tivanis/FER_ESC/BOM/Basket_Nov01_0350PM.xls

SHOPPING BASKET
This is not an invoice
01-Nov-20 15:50:01
 | Mouser No | Mfr. No | Manufacturer | Customer No | Description | RoHS | Lifecycle | Order Qty. | Price (EUR) | Ext.: (EUR)
1 | 80-C0603C104Z3V | C0603C104Z3VACTU | KEMET | C6, C15, C20, C21, C2 | Multilayer Ceramic Capacitors MLCC - SMD/SMT 25V 0.1uF 0603 Y5V -20/+80% | RoHS Compliant |  | 30 | 0,012 € | 0,36 €
2 | 667-EEH-ZS1J151V | EEH-ZS1J151V | Panasonic | C7, C8, C9, C3, C4, C | Aluminium Organic Polymer Capacitors 63VDC 150uF Anti-V Hybrid Cap AEC-Q200 | RoHS Compliant |  | 8 | 2,29 € | 18,32 €
3 | 80-C0603C102K1R | C0603C102K1RACTU | KEMET | C10, C19, C22, | Multilayer Ceramic Capacitors MLCC - SMD/SMT 100V 1000pF 0603 X7R 10% | RoHS Compliant |  | 3 | 0,085 € | 0,26 €
4 | 187-CL32B106KMVNNWE | CL32B106KMVNNWE | Samsung Electro-Mechanics | C11, C12, C13, C14, | Multilayer Ceramic Capacitors MLCC - SMD/SMT | RoHS Compliant | New At Mouser | 4 | 0,72 € | 2,88 €
5 | 80-C1206C224MMRECTU | C1206C224MMRECTU | KEMET | C16, C17, C18, | Multilayer Ceramic Capacitors MLCC - SMD/SMT 63V 0.22uF X7R 1206 20% | RoHS Compliant |  | 3 | 0,271 € | 0,81 €
6 | 81-GRM21BC72A105KE1L | GRM21BC72A105KE01L | Murata | C23, C24, | Multilayer Ceramic Capacitors MLCC - SMD/SMT 1.0UF 100V 10% 0805 | RoHS Compliant |  | 2 | 0,356 € | 0,71 €
7 | 710-885012107018 | 885012107018 | Wurth Elektronik | C26, C27, C46, C55, C | Multilayer Ceramic Capacitors MLCC - SMD/SMT WCAP-CSGP 4.7uF 0805 20% 25V MLCC | RoHS Compliant |  | 5 | 0,144 € | 0,72 €
8 | 77-VJ805Y105KXXTW1BC | VJ0805Y105KXXTW1BC | Vishay | C28, | Multilayer Ceramic Capacitors MLCC - SMD/SMT 1uF 25volts 10% | RoHS Compliant |  | 1 | 0,144 € | 0,14 €
9 | 963-EMK212BBJ106MGHT | EMK212BBJ106MGHT | Taiyo Yuden | C29, C33, C30, C34, C | Multilayer Ceramic Capacitors MLCC - SMD/SMT 0805 16VDC 10uF 20% X5R AEC-Q200 | RoHS Compliant |  | 8 | 0,203 € | 1,62 €
10 | 710-885012206077 | 885012206077 | Wurth Elektronik | C37, C38, C39, | Multilayer Ceramic Capacitors MLCC - SMD/SMT WCAP-CSGP 100pF 0603 10% 50V MLCC | RoHS Compliant |  | 3 | 0,085 € | 0,26 €
11 | 80-C0603C104M5R | C0603C104M5RACTU | KEMET | C40, | Multilayer Ceramic Capacitors MLCC - SMD/SMT 50V 0.1uF 0603 X7R 20% | RoHS Compliant |  | 1 | 0,085 € | 0,09 €
12 | 710-885012206089 | 885012206089 | Wurth Elektronik | C41, | Multilayer Ceramic Capacitors MLCC - SMD/SMT WCAP-CSGP 0.01uF 0603 10% 50V MLCC | RoHS Compliant |  | 1 | 0,085 € | 0,09 €
13 | 77-VJ0603A470JXXPBC | VJ0603A470JXXPW1BC | Vishay | C45, C47, | Multilayer Ceramic Capacitors MLCC - SMD/SMT 0603 47pF 25volts C0G 5% | RoHS Compliant |  | 2 | 0,085 € | 0,17 €
14 | 710-885012207128 | 885012207128 | Wurth Elektronik | C53, C60, C51, | Multilayer Ceramic Capacitors MLCC - SMD/SMT WCAP-CSGP 100V 0.1uF 0805 10% | RoHS Compliant |  | 3 | 0,085 € | 0,26 €
15 | 80-C0603C223K1R | C0603C223K1RACTU | KEMET | C59, | Multilayer Ceramic Capacitors MLCC - SMD/SMT 100V .022uF 0603 X7R 10% | RoHS Compliant |  | 1 | 0,085 € | 0,09 €
16 | 603-CC0603JRX77BB474 | CC0603JRX7R7BB474 | Yageo | C61, C62, C63, | Multilayer Ceramic Capacitors MLCC - SMD/SMT 16V 0.47uF X7R 0603 0.05 | RoHS Compliant |  | 3 | 0,186 € | 0,56 €
17 | 187-CL10A225KO8NNNC | CL10A225KO8NNNC | Samsung Electro-Mechanics | C78, C75, C72, C69, C | Multilayer Ceramic Capacitors MLCC - SMD/SMT | RoHS Compliant | New At Mouser | 6 | 0,093 € | 0,56 €
18 | 603-AC0402JRNP9BN300 | AC0402JRNPO9BN300 | Yageo | C84, C83, | Multilayer Ceramic Capacitors MLCC - SMD/SMT 30pF 5% 50V AEC-Q200 | RoHS Compliant By Exemption |  | 2 | 0,085 € | 0,17 €
19 | 833-BAT54S-TP | BAT54S-TP | Micro Commercial Components (MCC) | D1, D2, D3, D4, | Schottky Diodes & Rectifiers 30V 200mA 0.6A 200mW 2.0uA 10pF | RoHS Compliant |  | 4 | 0,229 € | 0,92 €
20 | 755-RB168MM100TFTR | RB168MM100TFTR | ROHM Semiconductor | D5, | Schottky Diodes & Rectifiers 100V VR 1A 0.81V VF PMDU; SOD-123FL | RoHS Compliant | New Product | 1 | 0,339 € | 0,34 €
21 | 710-155060VS75300 | 155060VS75300 | Wurth Elektronik | D6, D7, D8, D10, | Standard LEDs - SMD WL-SMSW Wtrclr SdVw Grn 2V 20mA 572nm | RoHS Compliant | New Product | 4 | 0,322 € | 1,29 €
22 | 710-150060RS75000 | 150060RS75000 | Wurth Elektronik | D9, | Standard LEDs - SMD WL-SMCW SMDMono TpVw Waterclr 0603 Red | RoHS Compliant |  | 1 | 0,127 € | 0,13 €
23 | 581-F0603G0R15FNTR | F0603G0R15FNTR | AVX | F1, | Surface Mount Fuses 150 mA fuse | In Transition |  | 1 | 0,686 € | 0,69 €
24 | 963-BKP2125HS600-T | BKP2125HS600-T | Taiyo Yuden | FB1, | Ferrite Beads HI CUR LW RDC 0805 60OHMS 25% | RoHS Compliant |  | 1 | 0,085 € | 0,09 €
25 | 538-105314-1206 | 105314-1206 | Molex | J1, J4, | Headers & Wire Housings NanoFit RA Hdr TH DR 6Ckt 0.38um Au Blk | RoHS Compliant |  | 2 | 1,58 € | 3,16 €
26 | 649-10103594-0001LF | 10103594-0001LF | FCI / Amphenol | J3, | USB Connectors 5P Quick Connect Micro USB TypeB Rcpt | RoHS Compliant |  | 1 | 0,644 € | 0,64 €
27 | 538-22-28-4041 | 22-28-4041 | Molex | J5, | Headers & Wire Housings BKWY HDR STR 4P tin | RoHS Compliant |  | 1 | 0,178 € | 0,18 €
28 | 538-87914-1026 | 87914-1026 | Molex | J6, | Headers & Wire Housings 2.54mm DRSW Hdr TH 10Ckt | RoHS Compliant |  | 1 | 0,661 € | 0,66 €
29 | 875-TYS40306R8M-10 | TYS40306R8M-10 | Laird Performance Materials | L1, | Fixed Inductors 6.8uH 20% -40C +125C | RoHS Compliant |  | 1 | 0,229 € | 0,23 €
30 | 652-MH1608-300Y | MH1608-300Y | Bourns | L2, | Ferrite Beads 30 ohms 25% HIGH CURRENT | RoHS Compliant |  | 1 | 0,085 € | 0,09 €
31 | 863-NVBLS001N06C | NVBLS001N06C | ON Semiconductor | Q3, Q5, Q6, Q4, Q1, Q | MOSFET NFET TOLL 60V 1.0MO | RoHS Compliant | New Product | 6 | 3,67 € | 22,02 €
32 | 667-ERJ-P06J6R2V | ERJ-P06J6R2V | Panasonic | R1, R2, R10, R11, R22 | Thick Film Resistors - SMD 0805 6.2ohms 0.5W 5% Tol AEC-Q200 | RoHS Compliant By Exemption |  | 6 | 0,246 € | 1,48 €
33 | 652-CR0603FX-39R0ELF | CR0603-FX-39R0ELF | Bourns | R5, R12, R19, R26, R6 | Thick Film Resistors - SMD 39 ohm 1% | RoHS Compliant By Exemption |  | 8 | 0,085 € | 0,68 €
34 | 652-CR0603FX-4422ELF | CR0603-FX-4422ELF | Bourns | R8, R15, R20, R27, | Thick Film Resistors - SMD 44.2K ohm 1% | RoHS Compliant By Exemption |  | 4 | 0,085 € | 0,34 €
35 | 652-CR0603FX-2401ELF | CR0603-FX-2401ELF | Bourns | R9, R16, R21, R28, | Thick Film Resistors - SMD 2.4K ohm 1% | RoHS Compliant By Exemption |  | 4 | 0,085 € | 0,34 €
36 | 667-ERJ-PA3J223V | ERJ-PA3J223V | Panasonic | R25, R24, R14, R13, R | Thick Film Resistors - SMD 0603 22Kohm 5% Anti-Surge AEC-Q200 |  |  | 6 | 0,093 € | 0,56 €
37 | 652-CSS2H2512K3L00FE | CSS2H-2512K-3L00FE | Bourns | R30, R29, R18, R17, R | Current Sense Resistors - SMD 3.0mOHMS 4W 1% AEC-Q200 | RoHS Compliant |  | 6 | 0,737 € | 4,42 €
38 | 652-CR0603-FX-103ELF | CR0603-FX-1003ELF | Bourns | R31, | Thick Film Resistors - SMD 100K 1% 1/10 WATT | RoHS Compliant By Exemption |  | 1 | 0,085 € | 0,09 €
39 | 660-RN731JTTD5562B25 | RN731JTTD5562B25 | KOA Speer | R32, | Thin Film Resistors - SMD 0603 55K6 Ohms 0.1% 25PPM | RoHS Compliant |  | 1 | 0,674 € | 0,67 €
40 | 667-ERA-3AEB103V | ERA-3AEB103V | Panasonic | R33, R72, R73, | Thin Film Resistors - SMD 0603 1/10W 10Kohms 0.1% 25ppm | RoHS Compliant By Exemption |  | 3 | 0,296 € | 0,89 €
41 | 652-CR0603FX-3300ELF | CR0603-FX-3300ELF | Bourns | R34, R59, R60, R71, | Thick Film Resistors - SMD 330 ohm 1% | RoHS Compliant By Exemption |  | 4 | 0,085 € | 0,34 €
42 | 652-CR0603-FX-2001LF | CR0603-FX-2001ELF | Bourns | R37, R36, R35, R76, R | Thick Film Resistors - SMD 2K OHM 1% | RoHS Compliant By Exemption |  | 5 | 0,076 € | 0,38 €
43 | 652-CR0603FX-4701ELF | CR0603-FX-4701ELF | Bourns | R38, R40, R39, | Thick Film Resistors - SMD 4.7K ohm 1% | RoHS Compliant By Exemption |  | 3 | 0,085 € | 0,26 €
44 | 652-CR0603FX-1302ELF | CR0603-FX-1302ELF | Bourns | R41, R45, R49, | Thick Film Resistors - SMD 13K 1% 1/10W | RoHS Compliant By Exemption |  | 3 | 0,085 € | 0,26 €
45 | 652-CR0603FX-1332ELF | CR0603-FX-1332ELF | Bourns | R42, R46, R50, | Thick Film Resistors - SMD 13.3K 1% 1/10W | RoHS Compliant By Exemption |  | 3 | 0,085 € | 0,26 €
46 | 652-CR0603FX-2003ELF | CR0603-FX-2003ELF | Bourns | R43, R47, R51, | Thick Film Resistors - SMD 200K ohm 1% | RoHS Compliant By Exemption |  | 3 | 0,085 € | 0,26 €
47 | 652-CR0603-FX3301ELF | CR0603-FX-3301ELF | Bourns | R44, R48, R52, R53, R | Thick Film Resistors - SMD 3.3KOHM 1/10WATT 1% | RoHS Compliant |  | 11 | 0,023 € | 0,25 €
48 | 667-ERJ-3EKF60R4V | ERJ-3EKF60R4V | Panasonic | R54, R55, | Thick Film Resistors - SMD 0603 60.4ohms 1% AEC-Q200 | RoHS Compliant By Exemption |  | 2 | 0,085 € | 0,17 €
49 | 652-CR0603FX-27R0ELF | CR0603-FX-27R0ELF | Bourns | R56, R57, | Thick Film Resistors - SMD 27 ohm 1% | RoHS Compliant By Exemption |  | 2 | 0,085 € | 0,17 €
50 | 652-CR0603FX-1002ELF | CR0603-FX-1002ELF | Bourns | R58, R61, R65, | Thick Film Resistors - SMD 10K 1% 1/10W | RoHS Compliant By Exemption |  | 3 | 0,085 € | 0,26 €
51 | 603-AC0603JR-100RL | AC0603JR-100RL | Yageo | R66, R67, R74, | Thick Film Resistors - SMD 0 ohm 5% 75V AEC-Q200 | RoHS Compliant By Exemption |  | 3 | 0,085 € | 0,26 €
52 | 652-CR0603AFX10R0EAS | CR0603AFX-10R0EAS | Bourns | R70, R69, R68, | Thick Film Resistors - SMD ResA-AS 0603 10R 1% 100mW TC100 | RoHS Compliant | New Product | 3 | 0,085 € | 0,26 €
53 | 688-SKRKAEE020 | SKRKAEE020 | Alps Alpine | SW1, | Tactile Switches 3.9x2.9x2.0mm 160gf Packaging Temp 80oC | RoHS Compliant |  | 1 | 0,626 € | 0,63 €
54 | 595-LMR16006XDDCR | LMR16006XDDCR | Texas Instruments | U1, | Switching Voltage Regulators LMR16006 SIMPLE SWIT 60V Buck | RoHS Compliant |  | 1 | 2,38 € | 2,38 €
55 | 511-LD1117S33 | LD1117S33TR | STMicroelectronics | U2, | LDO Voltage Regulators 3.3V 0.8A Positive | RoHS Compliant |  | 1 | 0,347 € | 0,35 €
56 | 511-LD1117S12 | LD1117S12TR | STMicroelectronics | U3, | LDO Voltage Regulators 1.2V 0.8A Positive | RoHS Compliant |  | 1 | 0,407 € | 0,41 €
57 | 595-TLC374CDR | TLC374CDR | Texas Instruments | U4, | Analog Comparators Quad Differential | RoHS Compliant |  | 1 | 1,14 € | 1,14 €
58 | 595-TCAN1042VDRQ1 | TCAN1042VDRQ1 | Texas Instruments | U5, | CAN Interface IC | RoHS Compliant |  | 1 | 1,11 € | 1,11 €
59 | 595-TPD2EUSB30ADRTR | TPD2EUSB30ADRTR | Texas Instruments | U6, | ESD Suppressors / TVS Diodes 2 Channel ESD/ Surge Solution | RoHS Compliant |  | 1 | 0,474 € | 0,47 €
60 | 895-FT230XS-R | FT230XS-R | FTDI | U7, | USB Interface IC USB to Basic Serial UART IC SSOP-16 | RoHS Compliant |  | 1 | 1,73 € | 1,73 €
61 | 771-NXS0104PW-Q100J | NXS0104PW-Q100J | Nexperia | U8, | Translation - Voltage Levels 3 STATE DUAL SUPPLY TRANS | RoHS Compliant | New Product | 1 | 0,584 € | 0,58 €
62 | 815-ABLS7M-20-B-2-T | ABLS7M-20.000MHZ-B-2-T | ABRACON | Y1, | Crystals 20.0MHz 18pF 50ppm -20C +70C | RoHS Compliant |  | 1 | 0,288 € | 0,29 €
63 | 595-F280049PZS | F280049PZS | Texas Instruments |  | 32-bit Microcontrollers - MCU | RoHS Compliant |  | 1 | 7,26 € | 7,26 €
64 | 538-105313-1203 | 105313-1203 | Molex |  | Headers & Wire Housings NanoFit RA Hdr TH SR 3Ckt 0.38UM Au Blk | RoHS Compliant |  | 2 | 1,06 € | 2,12 €
By submitting your order you agree to these terms and conditions. (https://hr.mouser.com/saleterms) |  |  |  |  |  |  |  |  | Merchandise Total: | 89,58 €
Prices are reflected at the date and time shown. |  |  |  |  |  |  |  |  | Delivery Charge: | 0,00 €
 |  |  |  |  |  |  |  |  | Back-order Delivery: | Estimate
