tivanis/FER_ESC/FER_ESC_v2r1.pdf

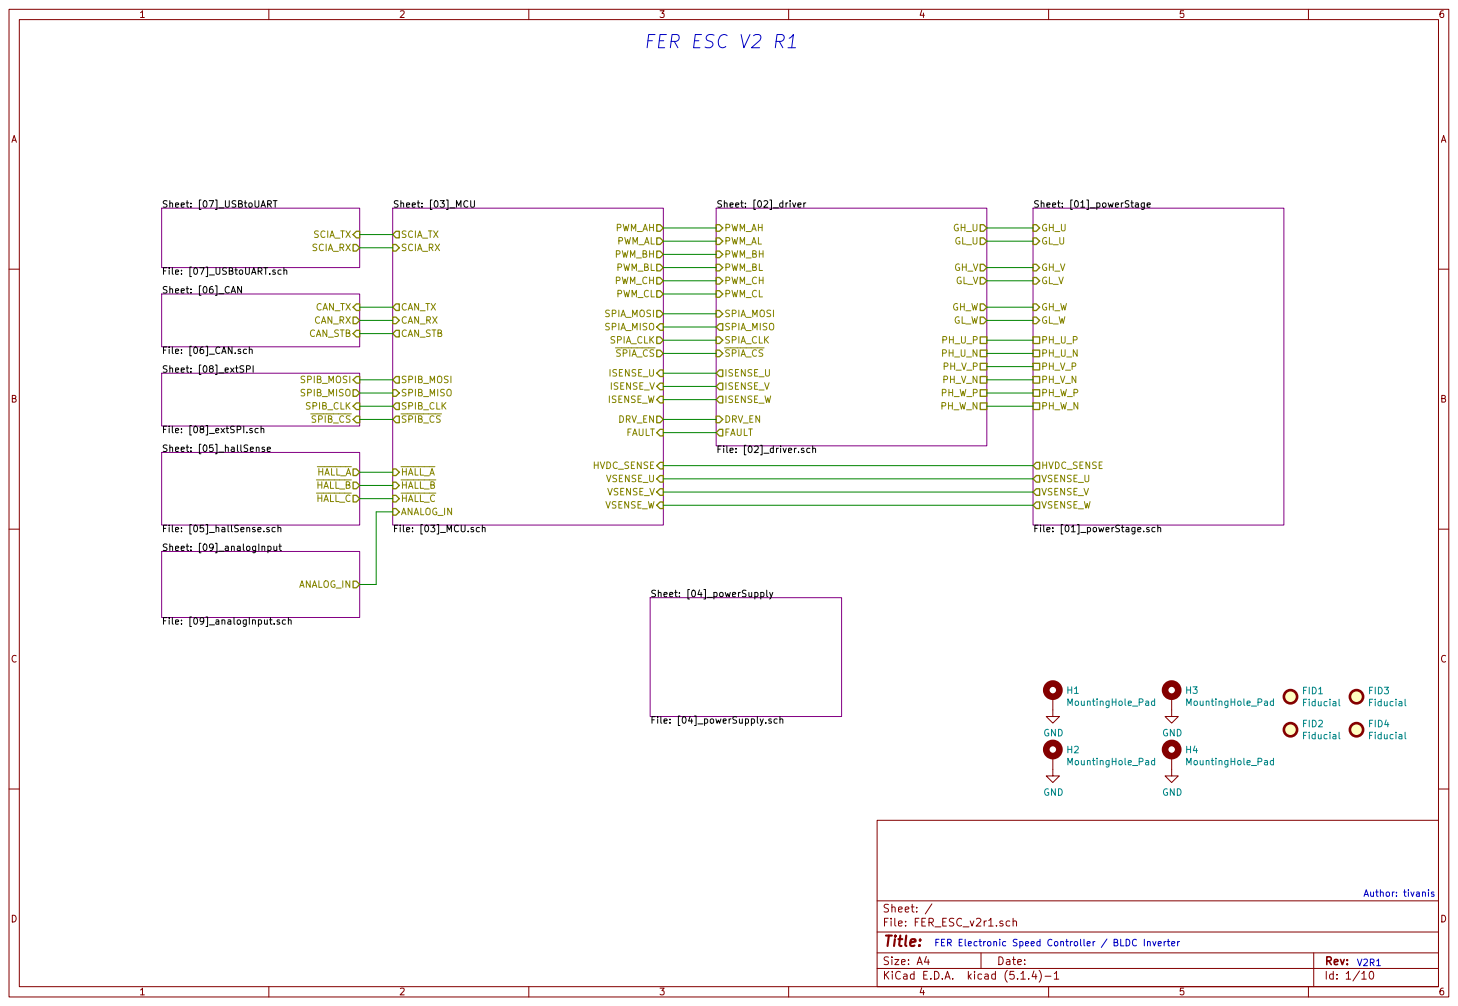
[picture p1: page 1]

File: FER_ESC_v2r1.sch Sheet: / Sheet: [04]_powerSupply

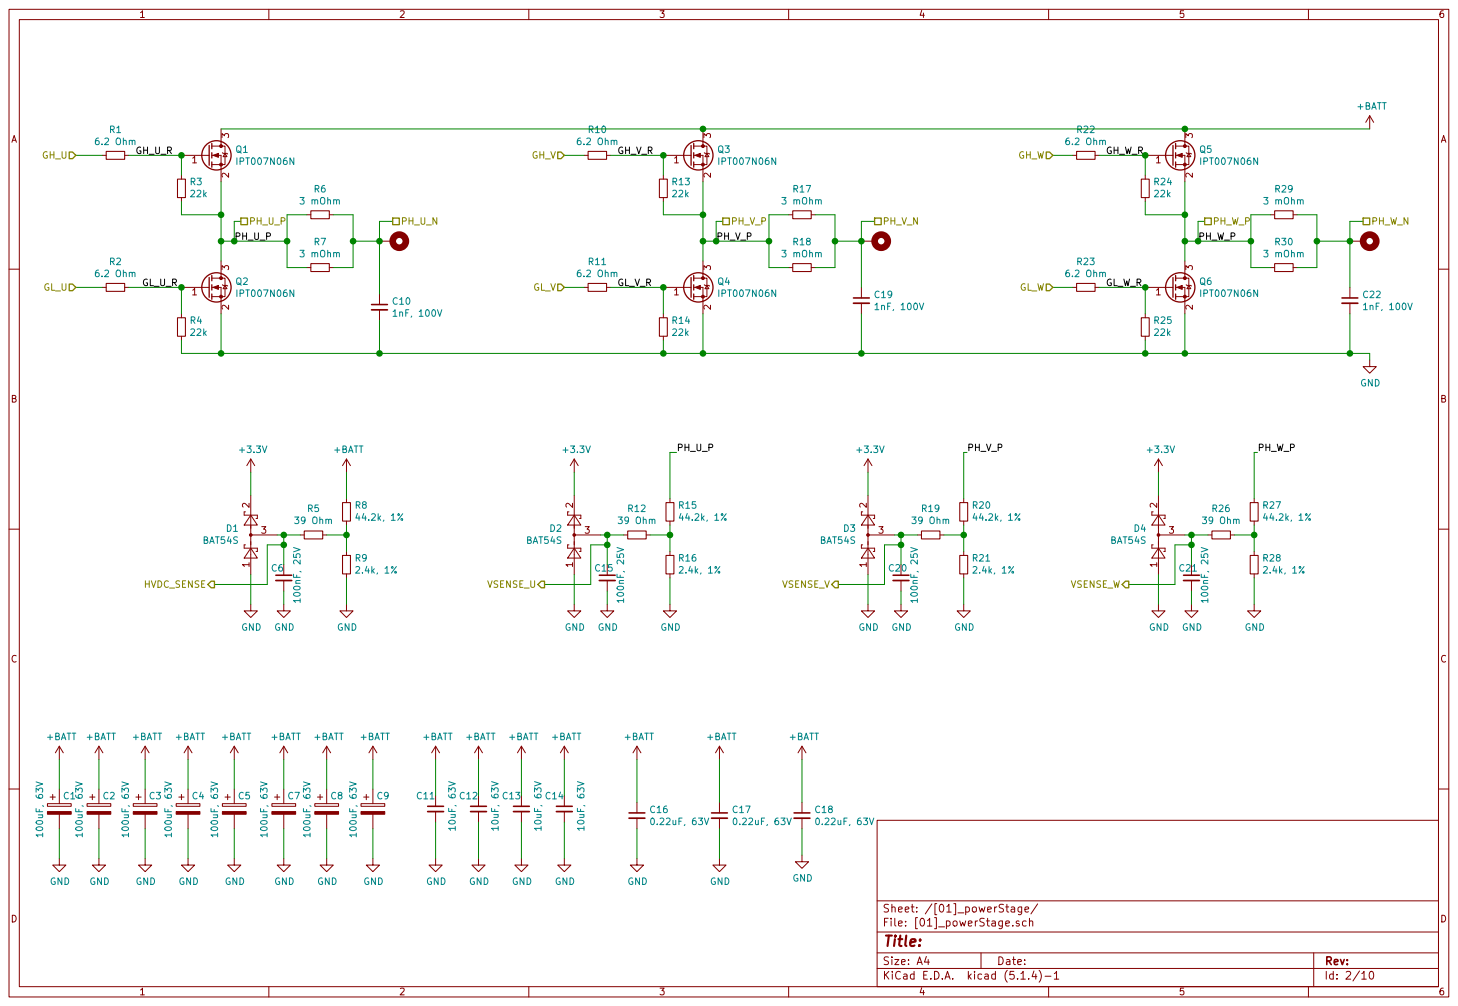
[picture p2: page 2]

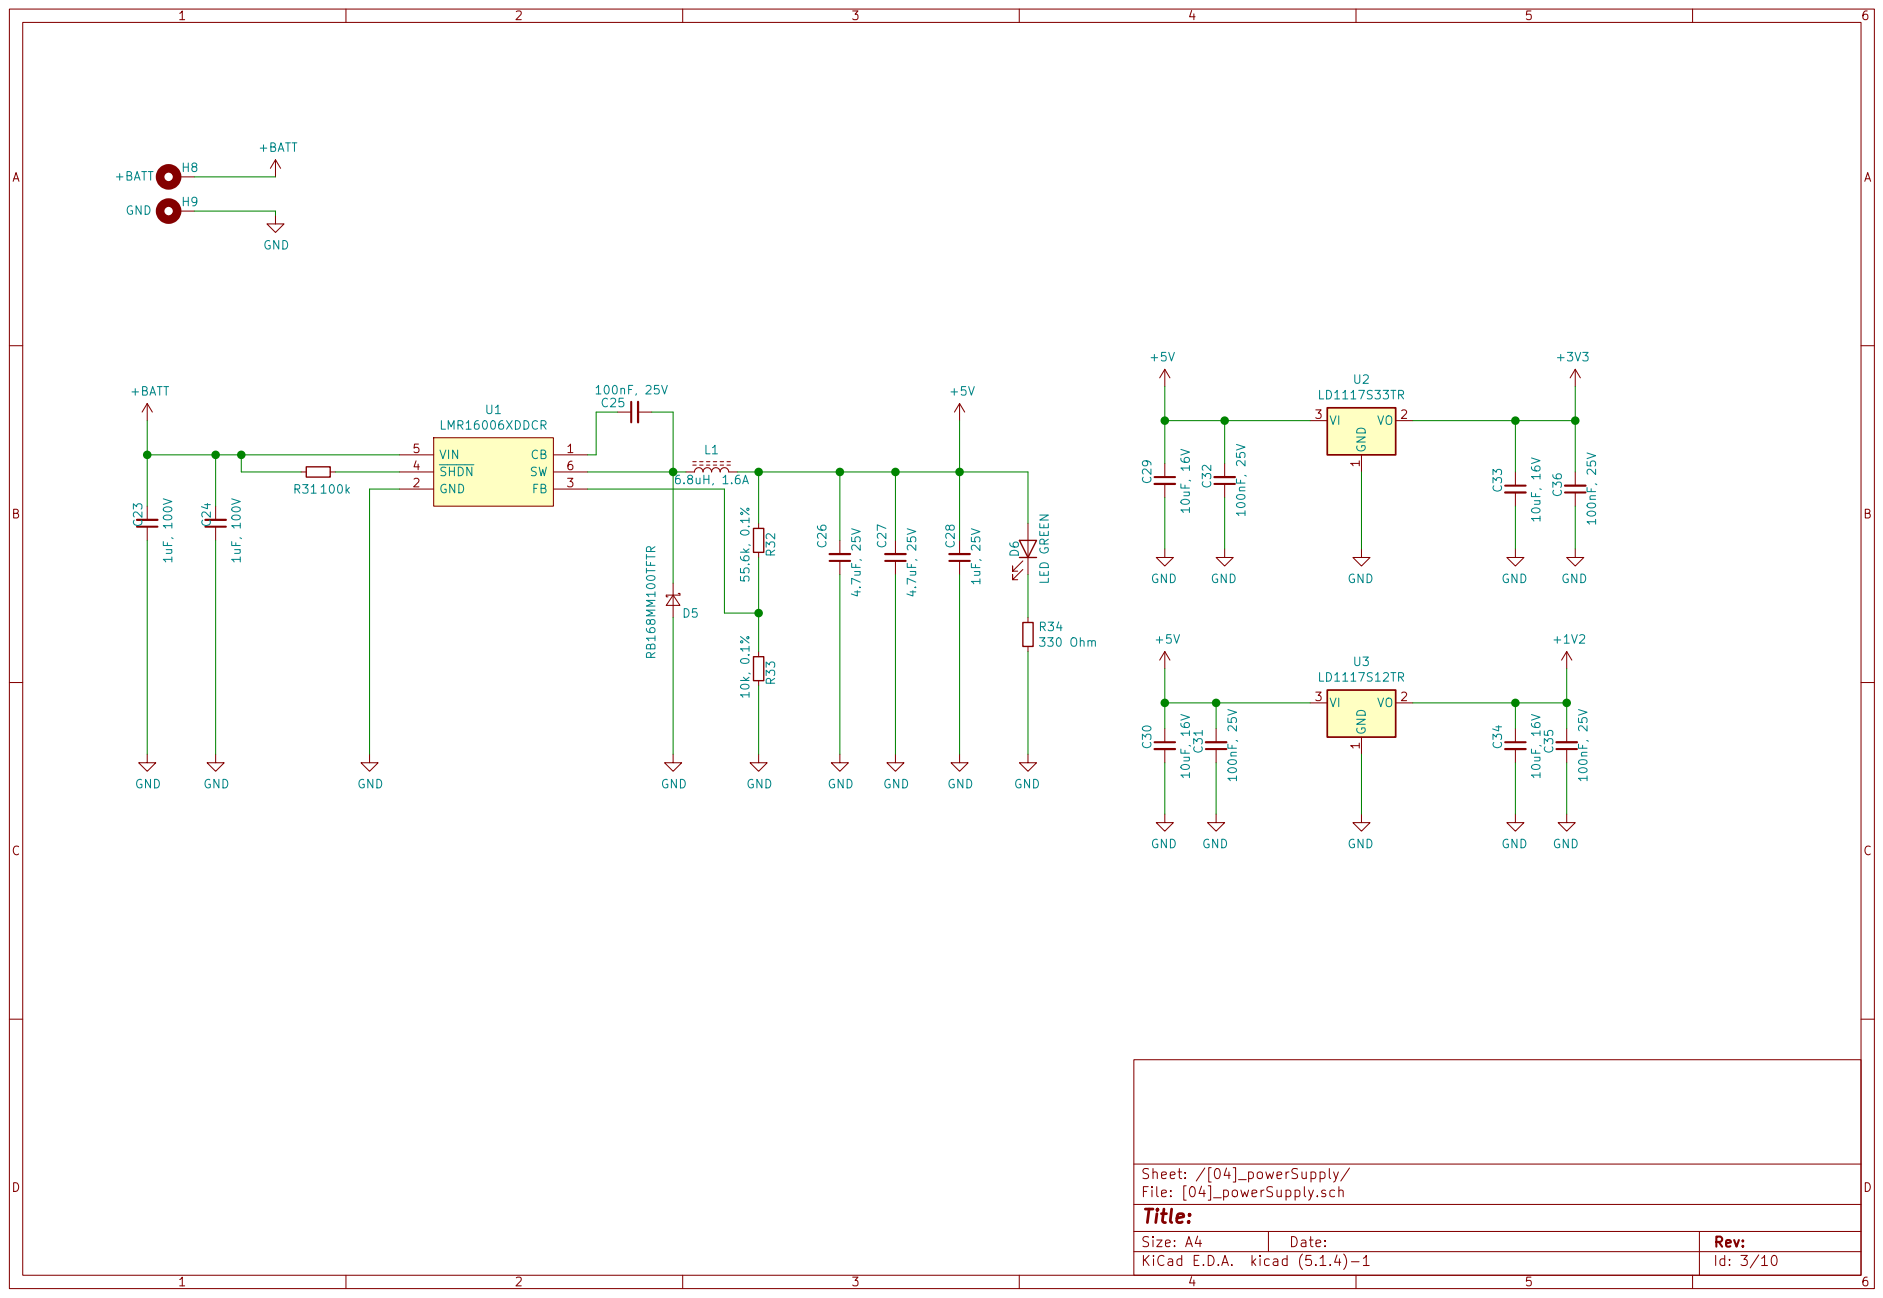
[picture p3: page 3]

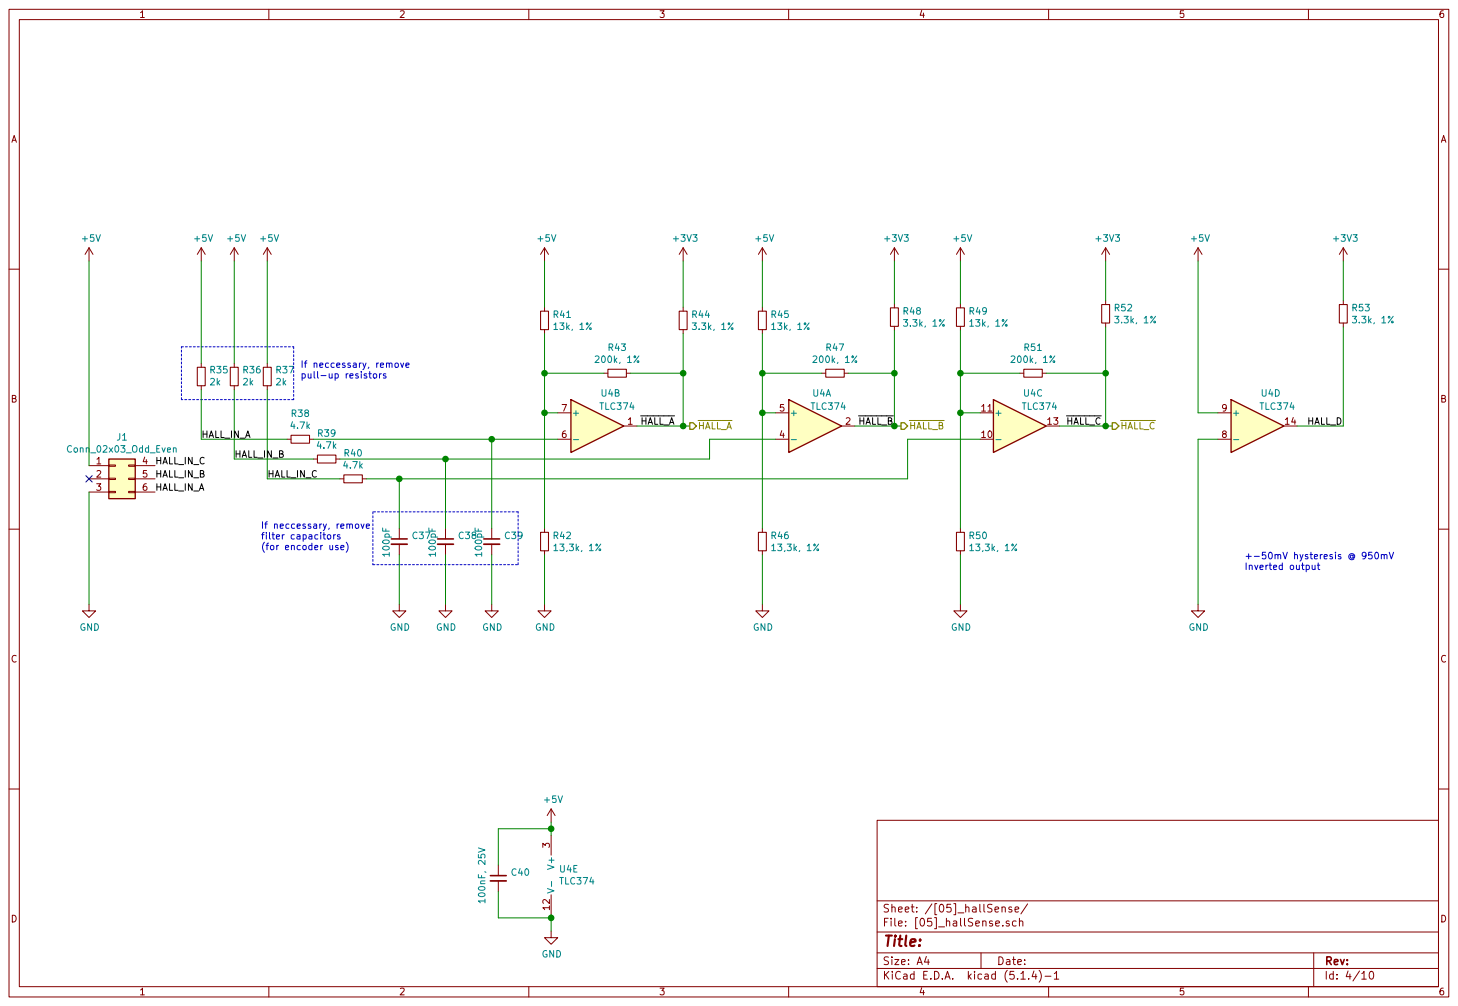
[picture p4: page 4]

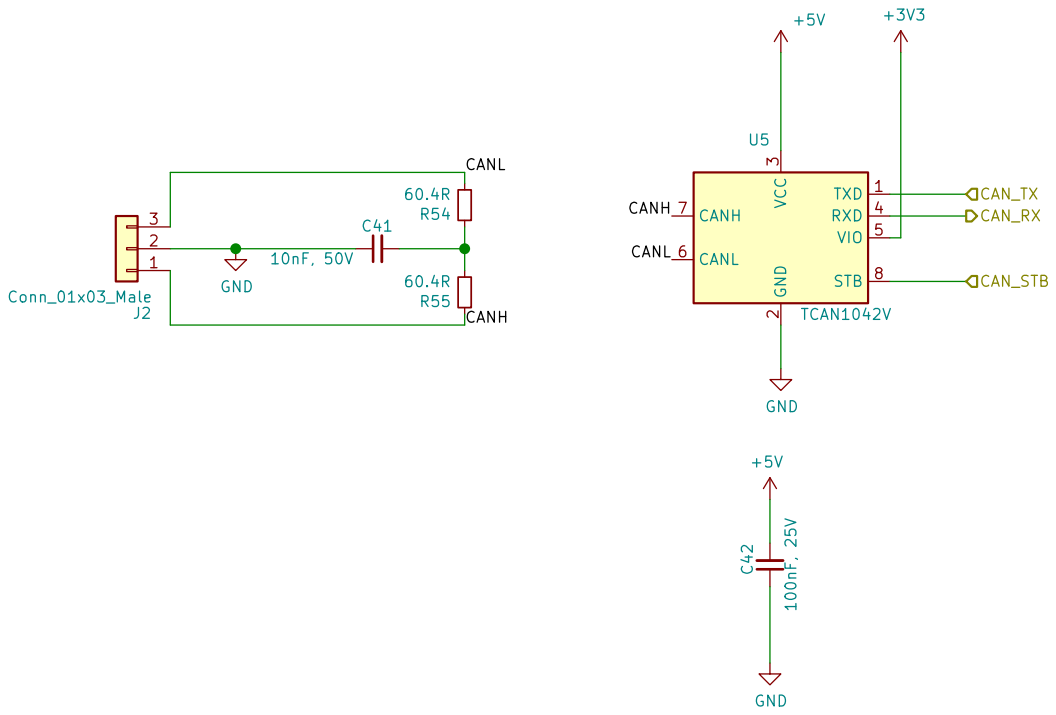
[picture p5: page 5]

3 RXD 4 VIO 5 CANL 6 CANH 7 STB 8 U5 TCAN1042V

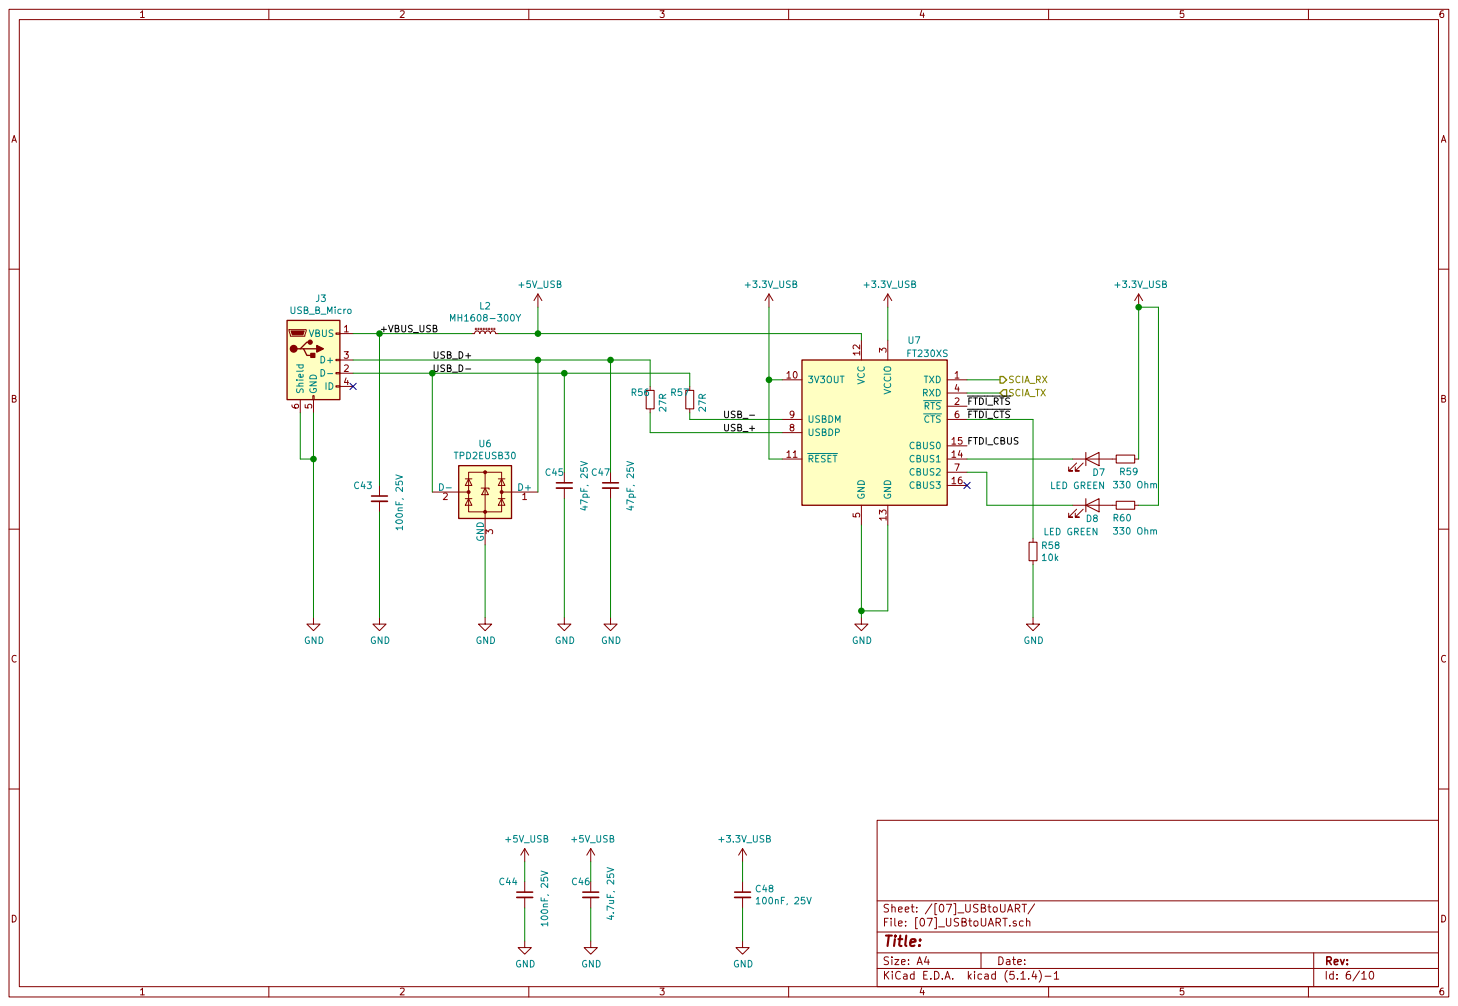
[picture p6: page 6]

5 CTS 6 CBUS2 7 USBDP 8 USBDM 9 U7 FT230XS GND

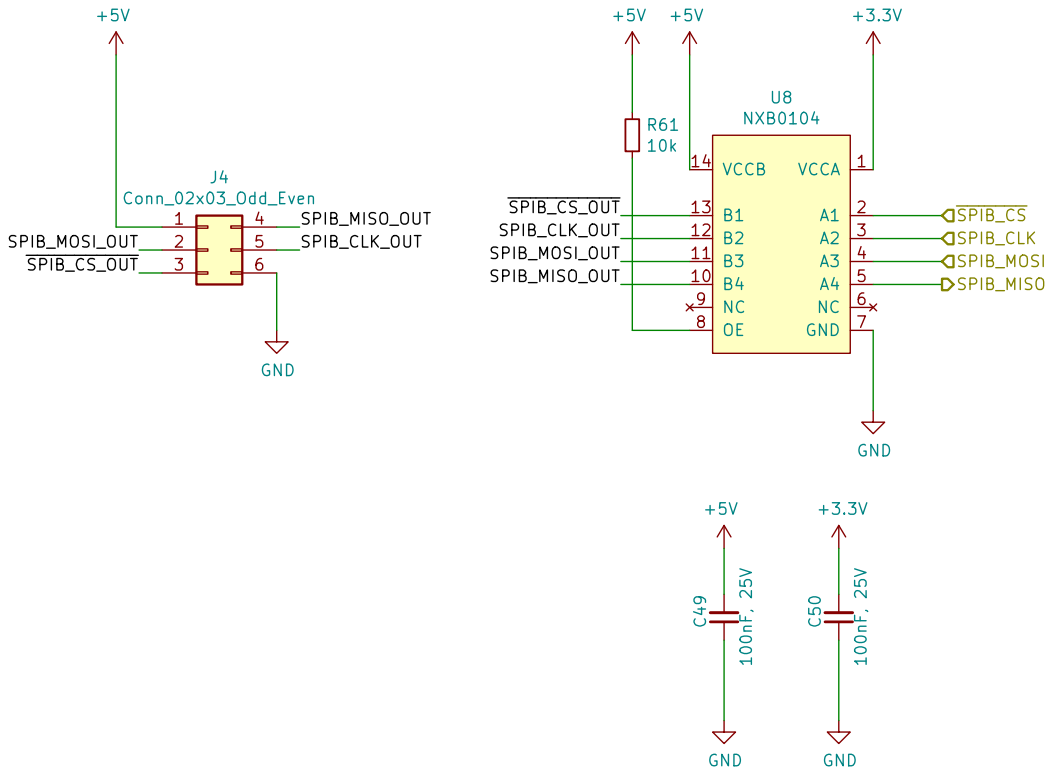
[picture p7: page 7]

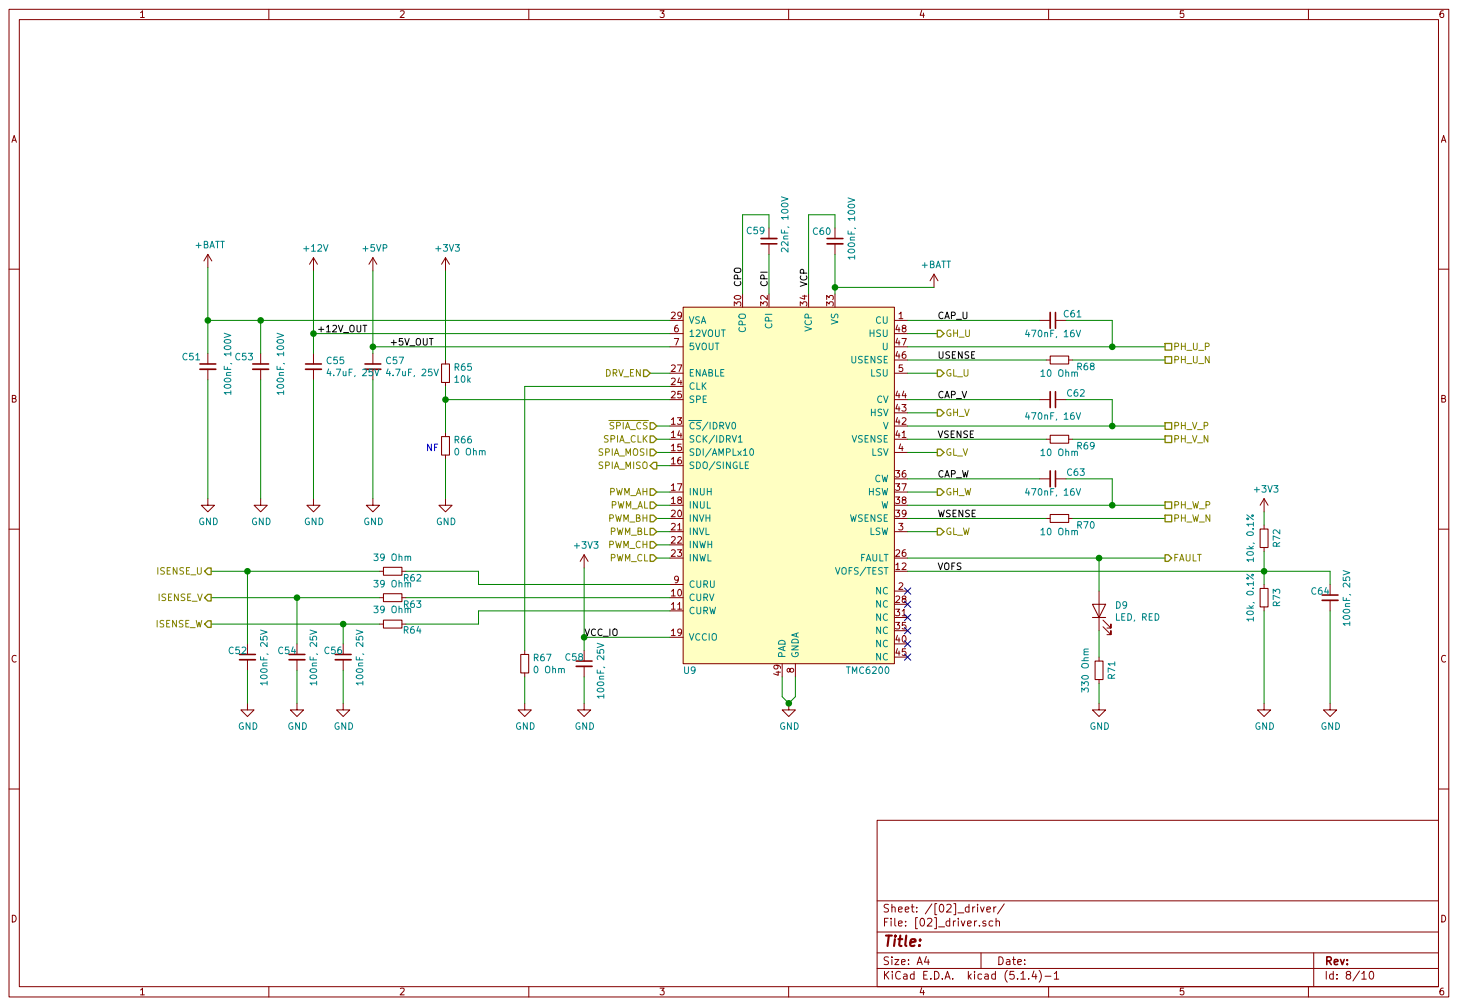
[picture p8: page 8]

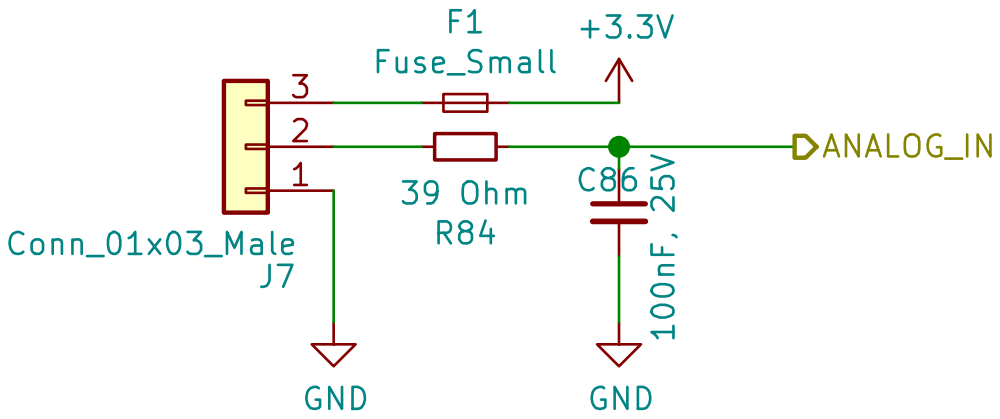
[picture p9: page 9]

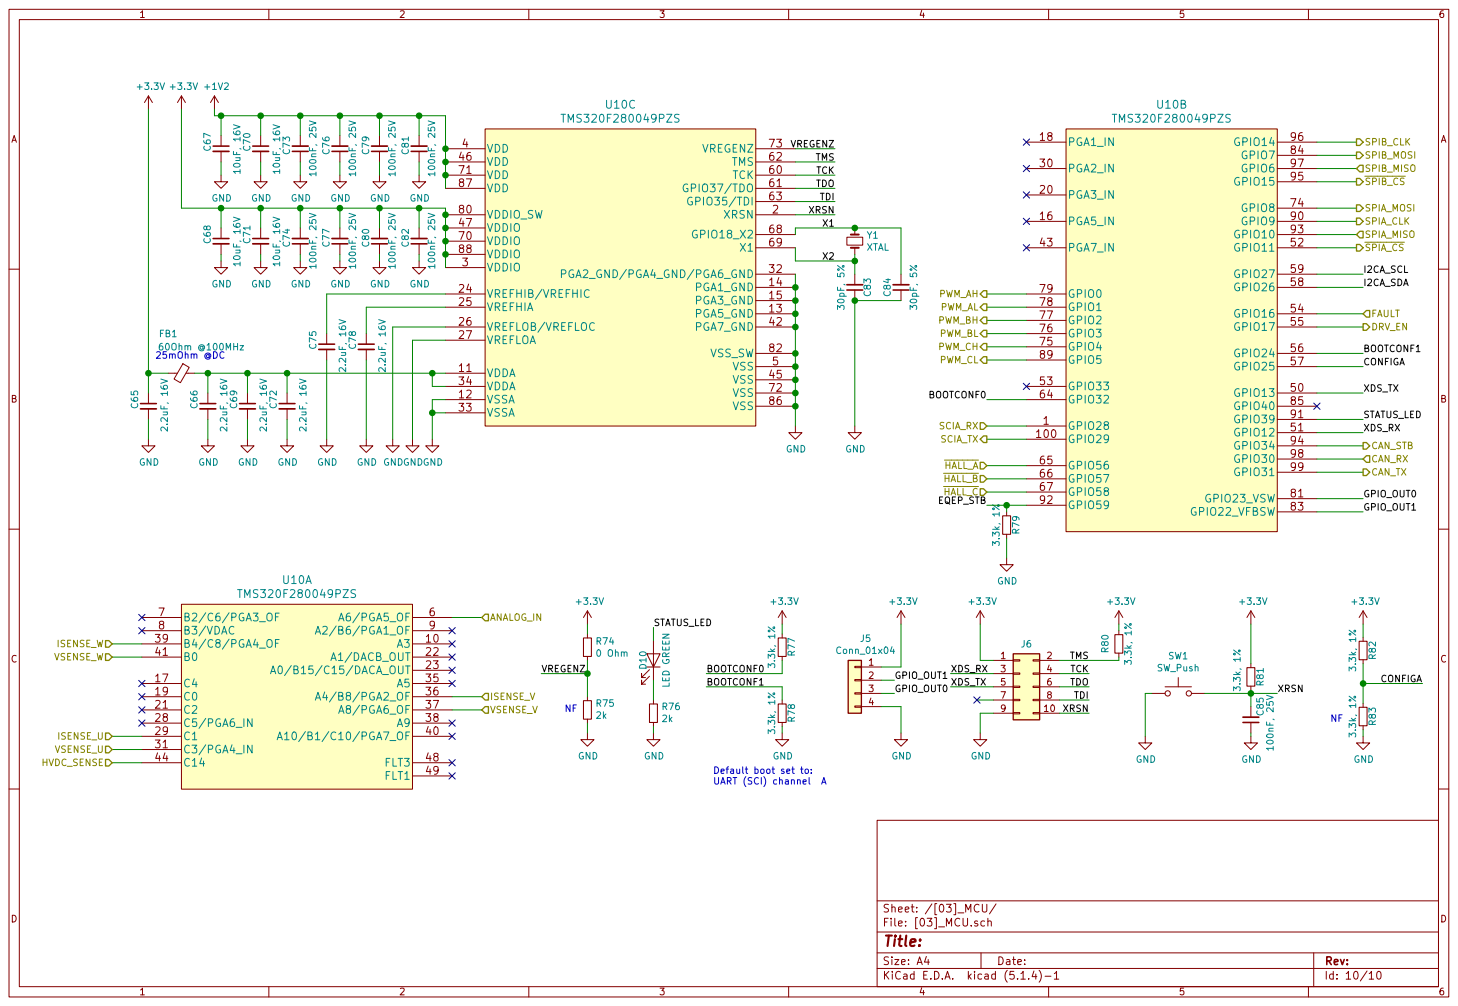
[picture p10: page 10]
