tivanis/FER_ESC/FER_ESC_v2r1.kicad_pcb

## KiCad design FER_ESC_v2r1.kicad_pcb (2021-03-23)

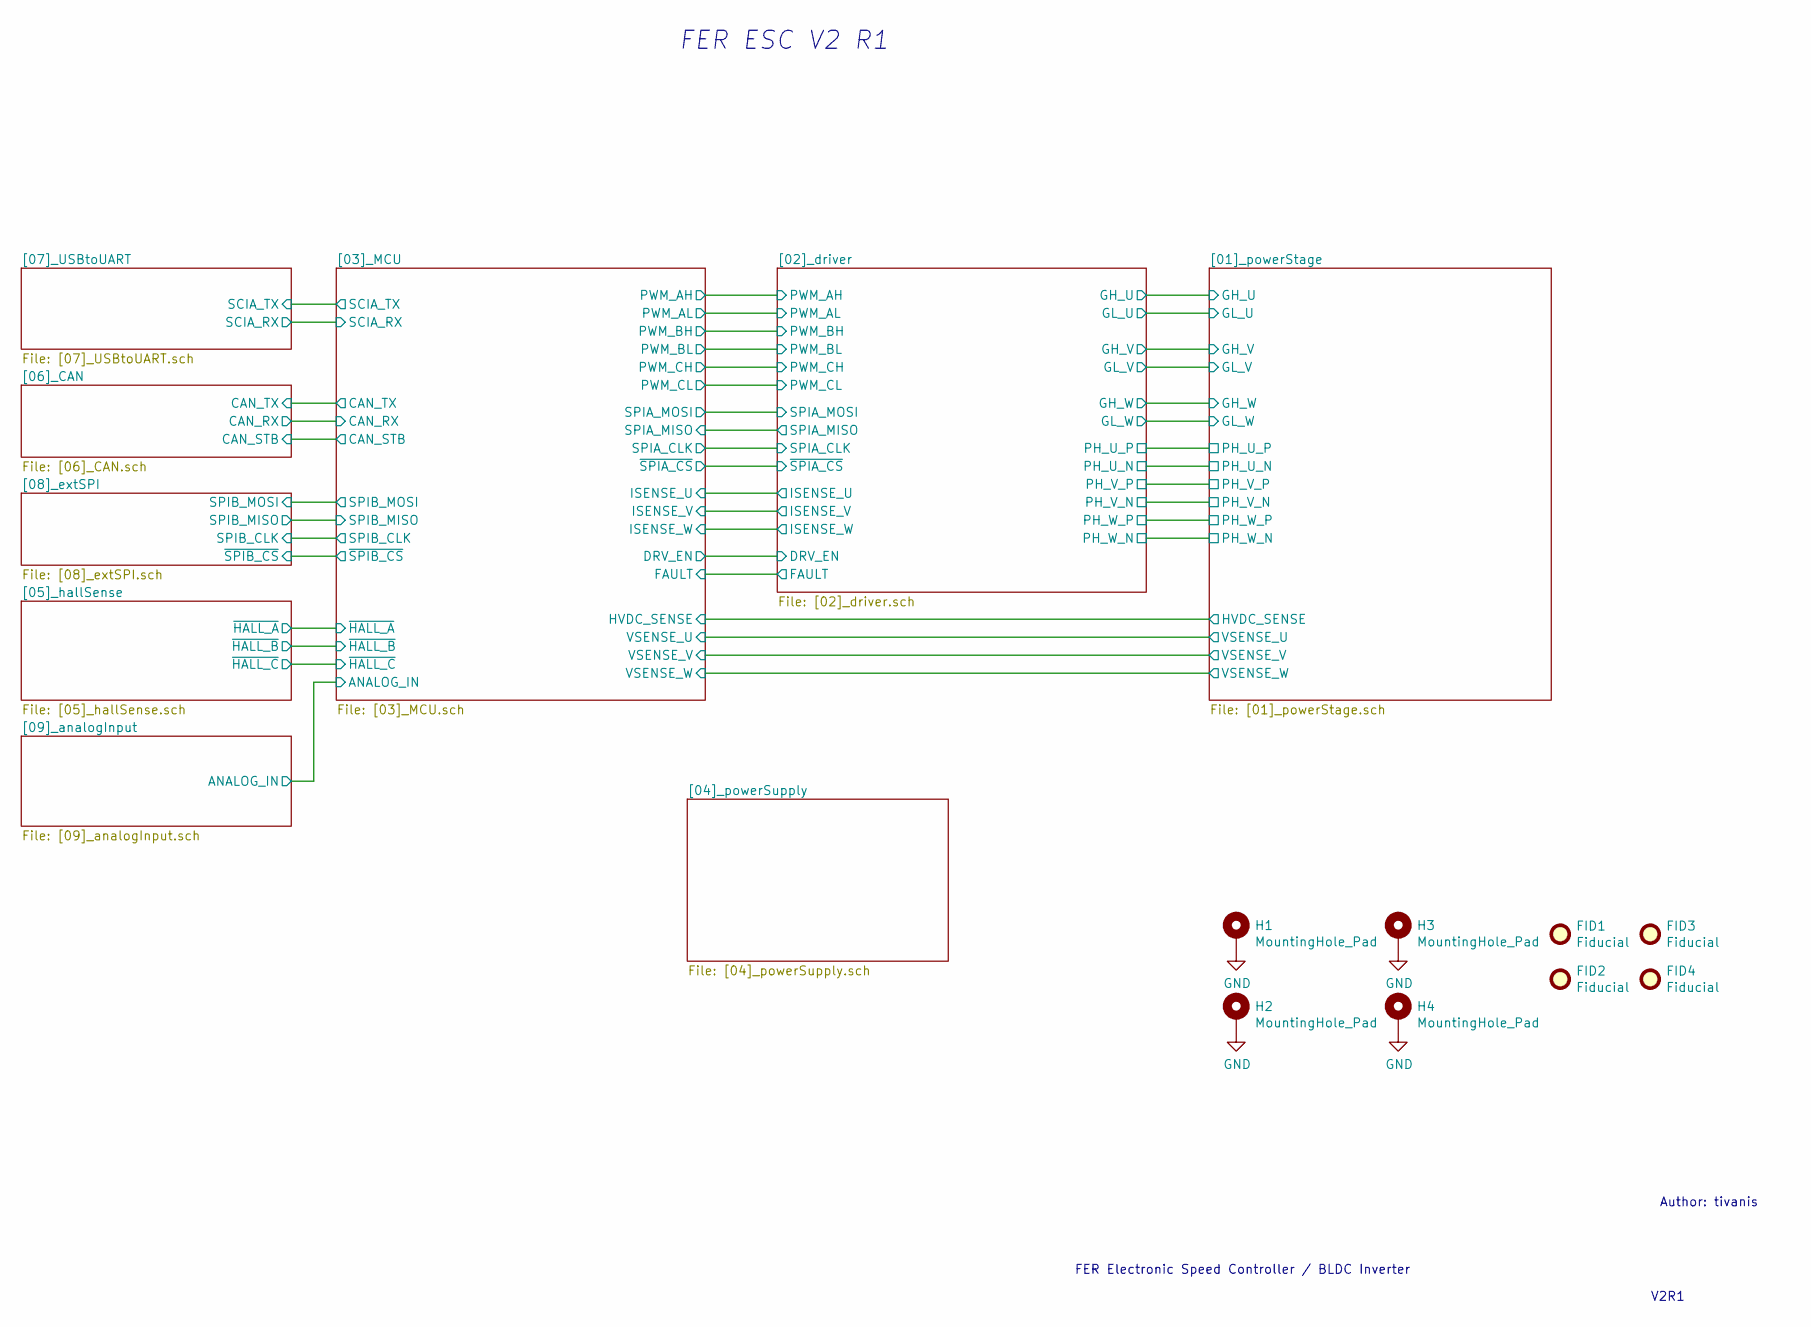
[picture p11: schematic FER_ESC_v2r1.sch]

Parts:
FID1, FID2, FID3, FID4: Fiducial; Fiducial_0.5mm_Mask1.5mm
H1, H2, H3, H4: MountingHole_Pad; MountingHole_3.2mm_M3_DIN965_Pad

Connections:
GND: H1.1, H2.1, H3.1, H4.1; also elsewhere on the board

Notes on the sheet:
FER ESC V2 R1
V2R1
FER Electronic Speed Controller / BLDC Inverter
Author: tivanis

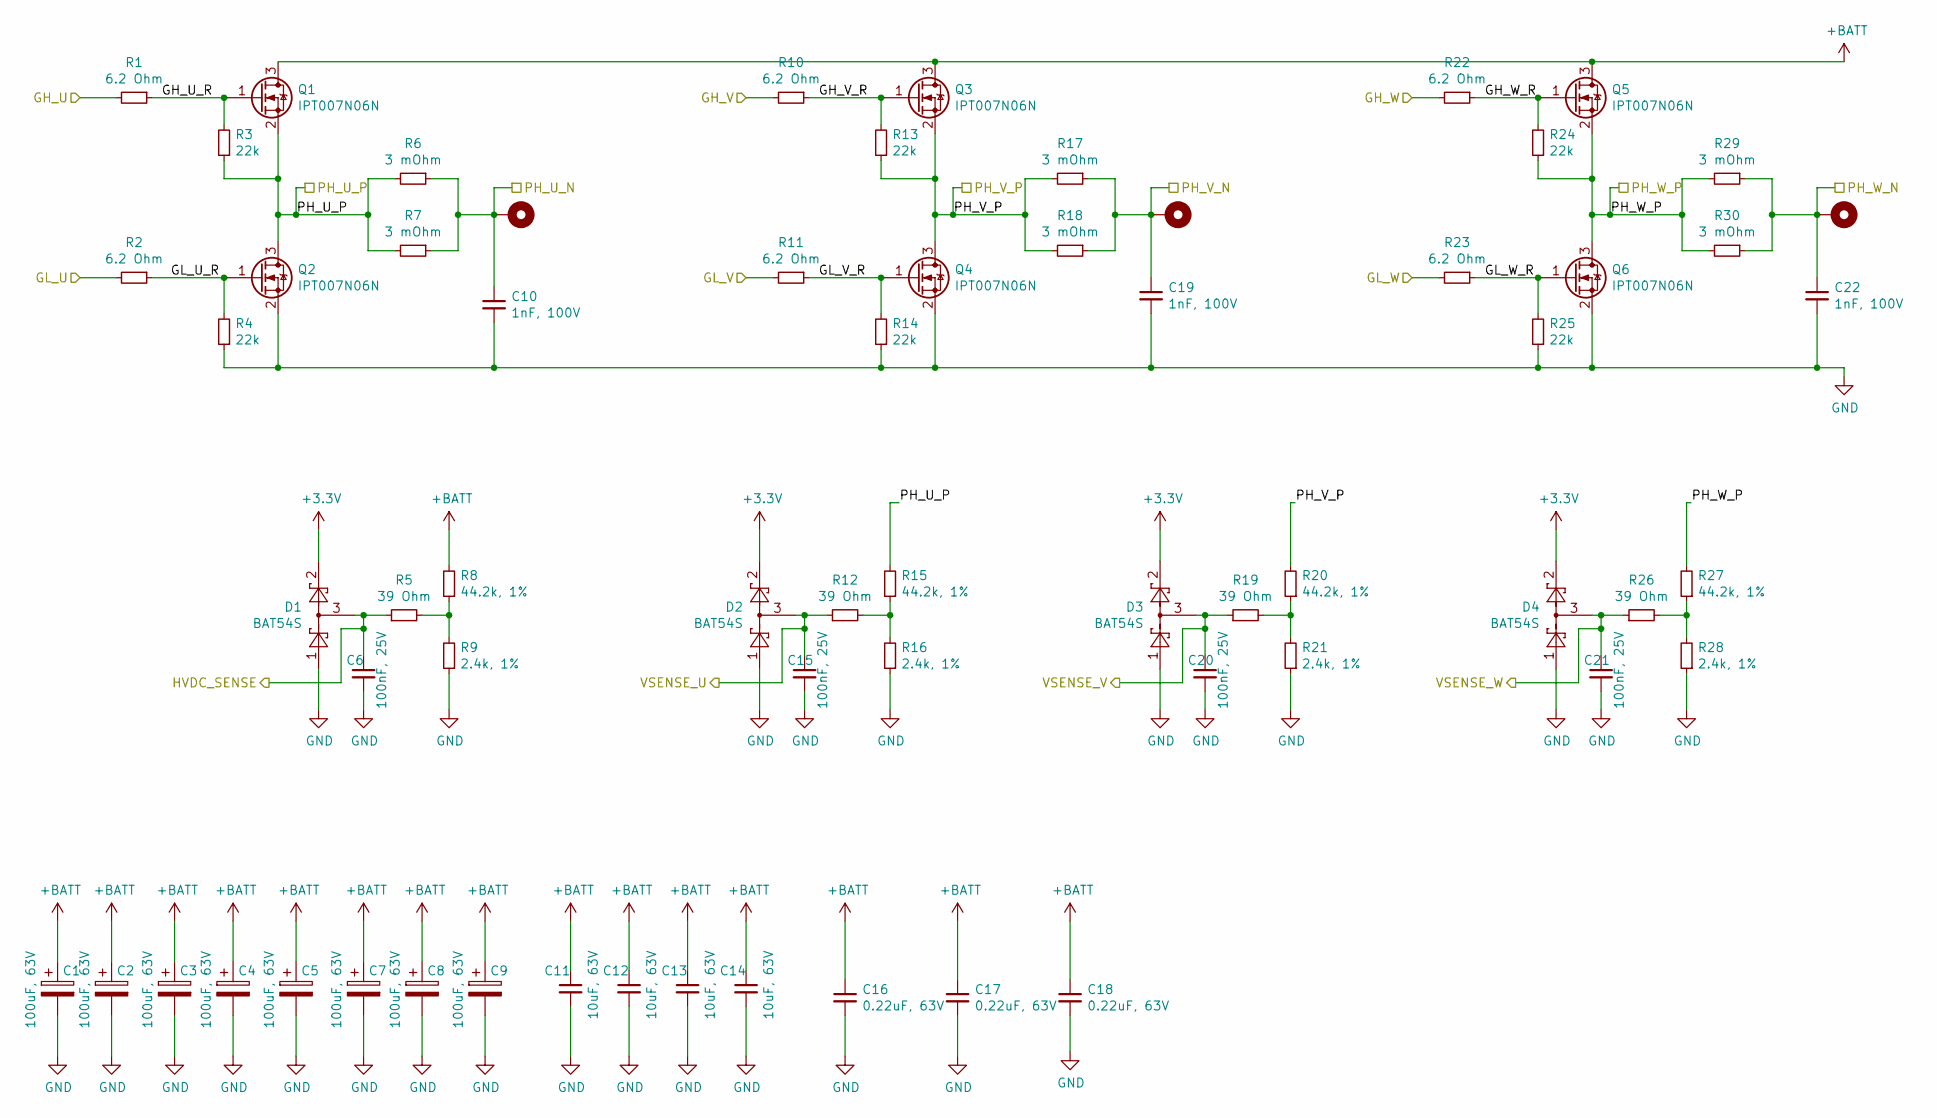
[picture p12: schematic [01]_powerStage.sch]

Parts:
C1, C2, C3, C4, C5, C7, C8, C9: 100uF, 63V; CP_Elec_10x14.3; Manufacturer Part Number EEH-ZS1J151V
C6, C15, C20, C21: 100nF, 25V; C_0603_1608Metric; Manufacturer Part Number C0603C104Z3VACTU
C10, C19, C22: 1nF, 100V; C_0603_1608Metric; Manufacturer Part Number C0603C102K1RACTU
C11, C12, C13, C14: 10uF, 63V; C_1210_3225Metric; Manufacturer Part Number CL32B106KMVNNWE
C16, C17, C18: 0.22uF, 63V; C_1206_3216Metric; Manufacturer Part Number C1206C224MMRECTU
D1, D2, D3, D4: BAT54S; SOT-23; Manufacturer Part Number BAT54S-TP
H5, H6, H7: MountingHole_Pad; MountingHole_4mm_Pad_Via
Q1, Q2, Q3, Q4, Q5, Q6: IPT007N06N; Infineon_PG-HSOF-8-1_ThermalVias; Manufacturer Part Number NVBLS001N06C
R1, R2, R10, R11, R22, R23: 6.2 Ohm; R_0805_2012Metric; Manufacturer Part Number ERJ-P06J6R2V
R3, R4, R13, R14, R24, R25: 22k; R_0805_2012Metric; Manufacturer Part Number ERJ-PA3J223V
R5, R12, R19, R26: 39 Ohm; R_0603_1608Metric; Manufacturer Part Number CR0603-FX-39R0ELF
R6, R7, R17, R18, R29, R30: 3 mOhm; R_2512_6332Metric; Manufacturer Part Number CSS2H-2512K-3L00FE
R8, R15, R20, R27: 44.2k, 1%; R_0603_1608Metric; Manufacturer Part Number CR0603-FX-4422ELF
R9, R16, R21, R28: 2.4k, 1%; R_0603_1608Metric; Manufacturer Part Number CR0603-FX-2401ELF

Connections:
+BATT: C1.1, C2.1, C3.1, C4.1, C5.1, C7.1, C8.1, C9.1, C11.1, C12.1, C13.1, C14.1, C16.1, C17.1, C18.1, Q1.3 (D), Q3.3 (D), Q5.3 (D), R8.2; also elsewhere on the board
/[01]_powerStage/GH_U: R1.2; also elsewhere on the board
/[01]_powerStage/GH_U_R: Q1.1 (G), R1.1, R3.2
/[01]_powerStage/GH_V: R10.2; also elsewhere on the board
/[01]_powerStage/GH_V_R: Q3.1 (G), R10.1, R13.2
/[01]_powerStage/GH_W: R22.2; also elsewhere on the board
/[01]_powerStage/GH_W_R: Q5.1 (G), R22.1, R24.2
/[01]_powerStage/GL_U: R2.2; also elsewhere on the board
/[01]_powerStage/GL_U_R: Q2.1 (G), R2.1, R4.2
/[01]_powerStage/GL_V: R11.2; also elsewhere on the board
/[01]_powerStage/GL_V_R: Q4.1 (G), R11.1, R14.2
/[01]_powerStage/GL_W: R23.2; also elsewhere on the board
/[01]_powerStage/GL_W_R: Q6.1 (G), R23.1, R25.2
/[01]_powerStage/HVDC_SENSE: C6.1, D1.3, R5.1; also elsewhere on the board
/[01]_powerStage/PH_U_N: C10.1, H5.1, R6.1, R7.1; also elsewhere on the board
/[01]_powerStage/PH_U_P: Q1.2 (S), Q2.3 (D), R3.1, R6.2, R7.2, R15.2; also elsewhere on the board
/[01]_powerStage/PH_V_N: C19.1, H6.1, R17.1, R18.1; also elsewhere on the board
/[01]_powerStage/PH_V_P: Q3.2 (S), Q4.3 (D), R13.1, R17.2, R18.2, R20.2; also elsewhere on the board
/[01]_powerStage/PH_W_N: C22.1, H7.1, R29.1, R30.1; also elsewhere on the board
/[01]_powerStage/PH_W_P: Q5.2 (S), Q6.3 (D), R24.1, R27.2, R29.2, R30.2; also elsewhere on the board
/[01]_powerStage/VSENSE_U: C15.1, D2.3, R12.1; also elsewhere on the board
/[01]_powerStage/VSENSE_V: C20.1, D3.3, R19.1; also elsewhere on the board
/[01]_powerStage/VSENSE_W: C21.1, D4.3, R26.1; also elsewhere on the board
GND: C1.2, C2.2, C3.2, C4.2, C5.2, C6.2, C7.2, C8.2, C9.2, C10.2, C11.2, C12.2, C13.2, C14.2, C15.2, C16.2, C17.2, C18.2, C19.2, C20.2, C21.2, C22.2, D1.1, D2.1, D3.1, D4.1, Q2.2 (S), Q4.2 (S), Q6.2 (S), R4.1, R9.1, R14.1, R16.1, R21.1, R25.1, R28.1; also elsewhere on the board
unnamed: R5.2, R8.1, R9.2
unnamed: R12.2, R15.1, R16.2
unnamed: R19.2, R20.1, R21.2
unnamed: R26.2, R27.1, R28.2

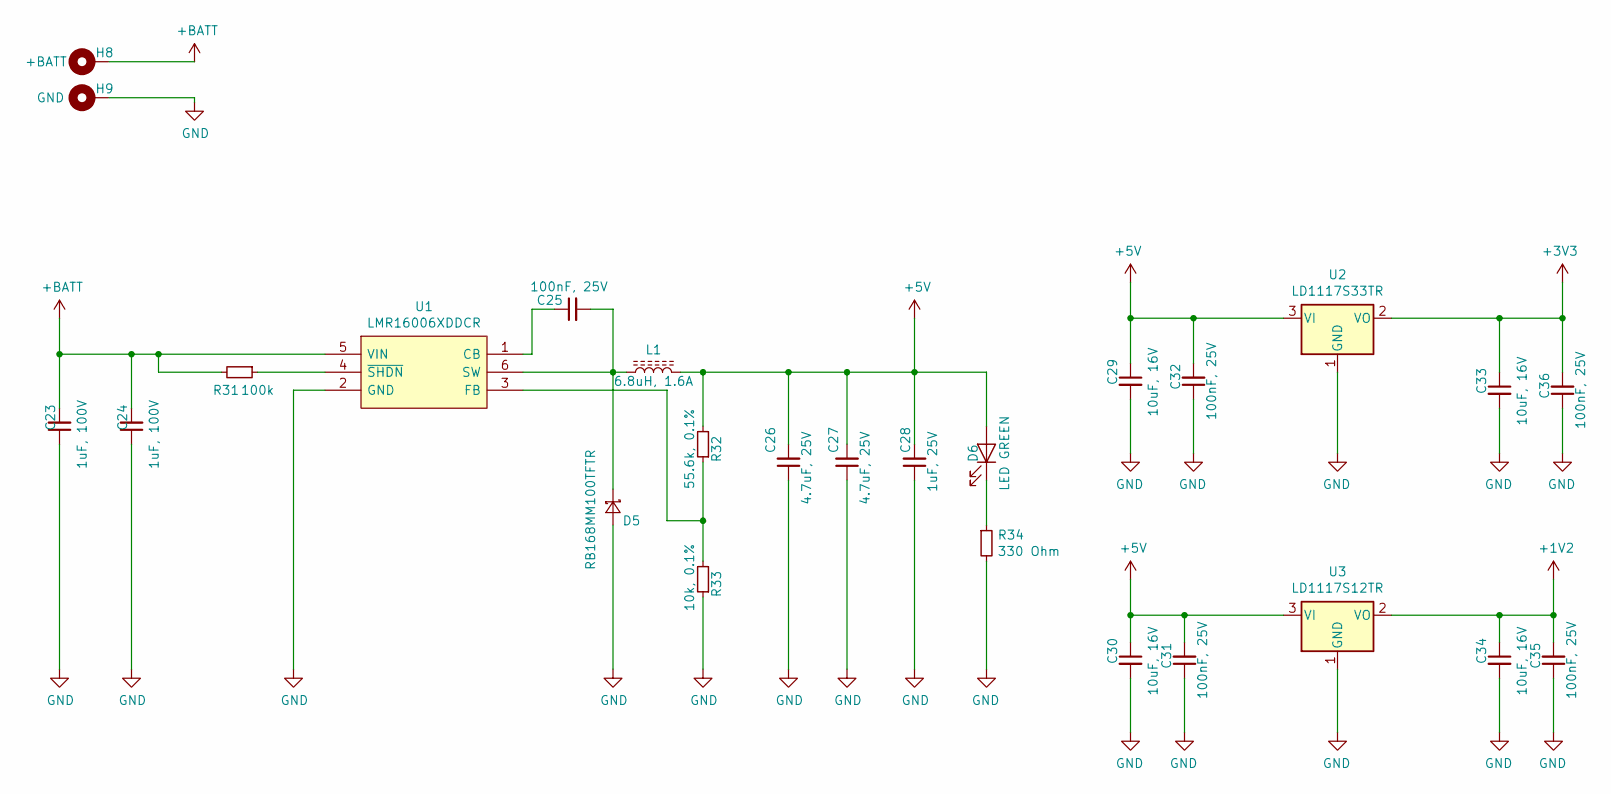
[picture p13: schematic [04]_powerSupply.sch]

Parts:
C23, C24: 1uF, 100V; C_0805_2012Metric; Mouser Part Number 81-GRM21BC72A105KE1L
C25, C31, C32, C35, C36: 100nF, 25V; C_0603_1608Metric; Manufacturer Part Number C0603C104Z3VACTU
C26, C27: 4.7uF, 25V; C_0805_2012Metric; Manufacturer Part Number 885012107018
C28: 1uF, 25V; C_0805_2012Metric; Mouser Part Number 603-CC805ZRY5V8BB105
C29, C30, C33, C34: 10uF, 16V; C_0805_2012Metric; Manufacturer Part Number EMK212BBJ106MGHT
D5: RB168MM100TFTR; D_SOD-123; Mouser Part Number 755-RB168MM100TFTR
D6: LED GREEN; LED_0603_1608Metric_Castellated; Manufacturer Part Number 155060VS75300
H8: +BATT; MountingHole_4mm_Pad_Via
H9: GND; MountingHole_4mm_Pad_Via
L1: 6.8uH, 1.6A; L_Taiyo-Yuden_NR-40xx_HandSoldering_ALT; Manufacturer Part Number TYS40306R8M-10
R31: 100k; R_0603_1608Metric; Manufacturer Part Number CR0603-FX-1003ELF
R32: 55.6k, 0.1%; R_0603_1608Metric; Manufacturer Part Number RN731JTTD5562B25
R33: 10k, 0.1%; R_0603_1608Metric; Manufacturer Part Number ERA-3AEB103V
R34: 330 Ohm; R_0603_1608Metric; Manufacturer Part Number CR0603-FX-3300ELF
U1: LMR16006XDDCR; TSOT-23-6; Manufacturer Part Number LMR16006XDDCR
U2: LD1117S33TR; SOT-223-3_TabPin2; Manufacturer Part Number LD1117S33TR
U3: LD1117S12TR; SOT-223-3_TabPin2; Manufacturer Part Number LD1117S12TR

Connections:
+1V2: C34.1, C35.2, U3.2 (VO); also elsewhere on the board
+5V: C26.2, C27.2, C28.2, C29.1, C30.1, C31.2, C32.2, D6.2 (A), L1.2, R32.2, U2.3 (VI), U3.3 (VI); also elsewhere on the board
+BATT: C23.2, C24.2, H8.1, R31.2, U1.5 (VIN); also elsewhere on the board
GND: C23.1, C24.1, C26.1, C27.1, C28.1, C29.2, C30.2, C31.1, C32.1, C33.2, C34.2, C35.1, C36.1, D5.2 (A), H9.1, R33.1, R34.2, U1.2 (GND), U2.1 (GND), U3.1 (GND); also elsewhere on the board
unnamed: C25.1, U1.1 (CB)
unnamed: C25.2, D5.1 (K), L1.1, U1.6 (SW)
unnamed: D6.1 (K), R34.1
unnamed: R31.1, U1.4 (~SHDN)
unnamed: R32.1, R33.2, U1.3 (FB)

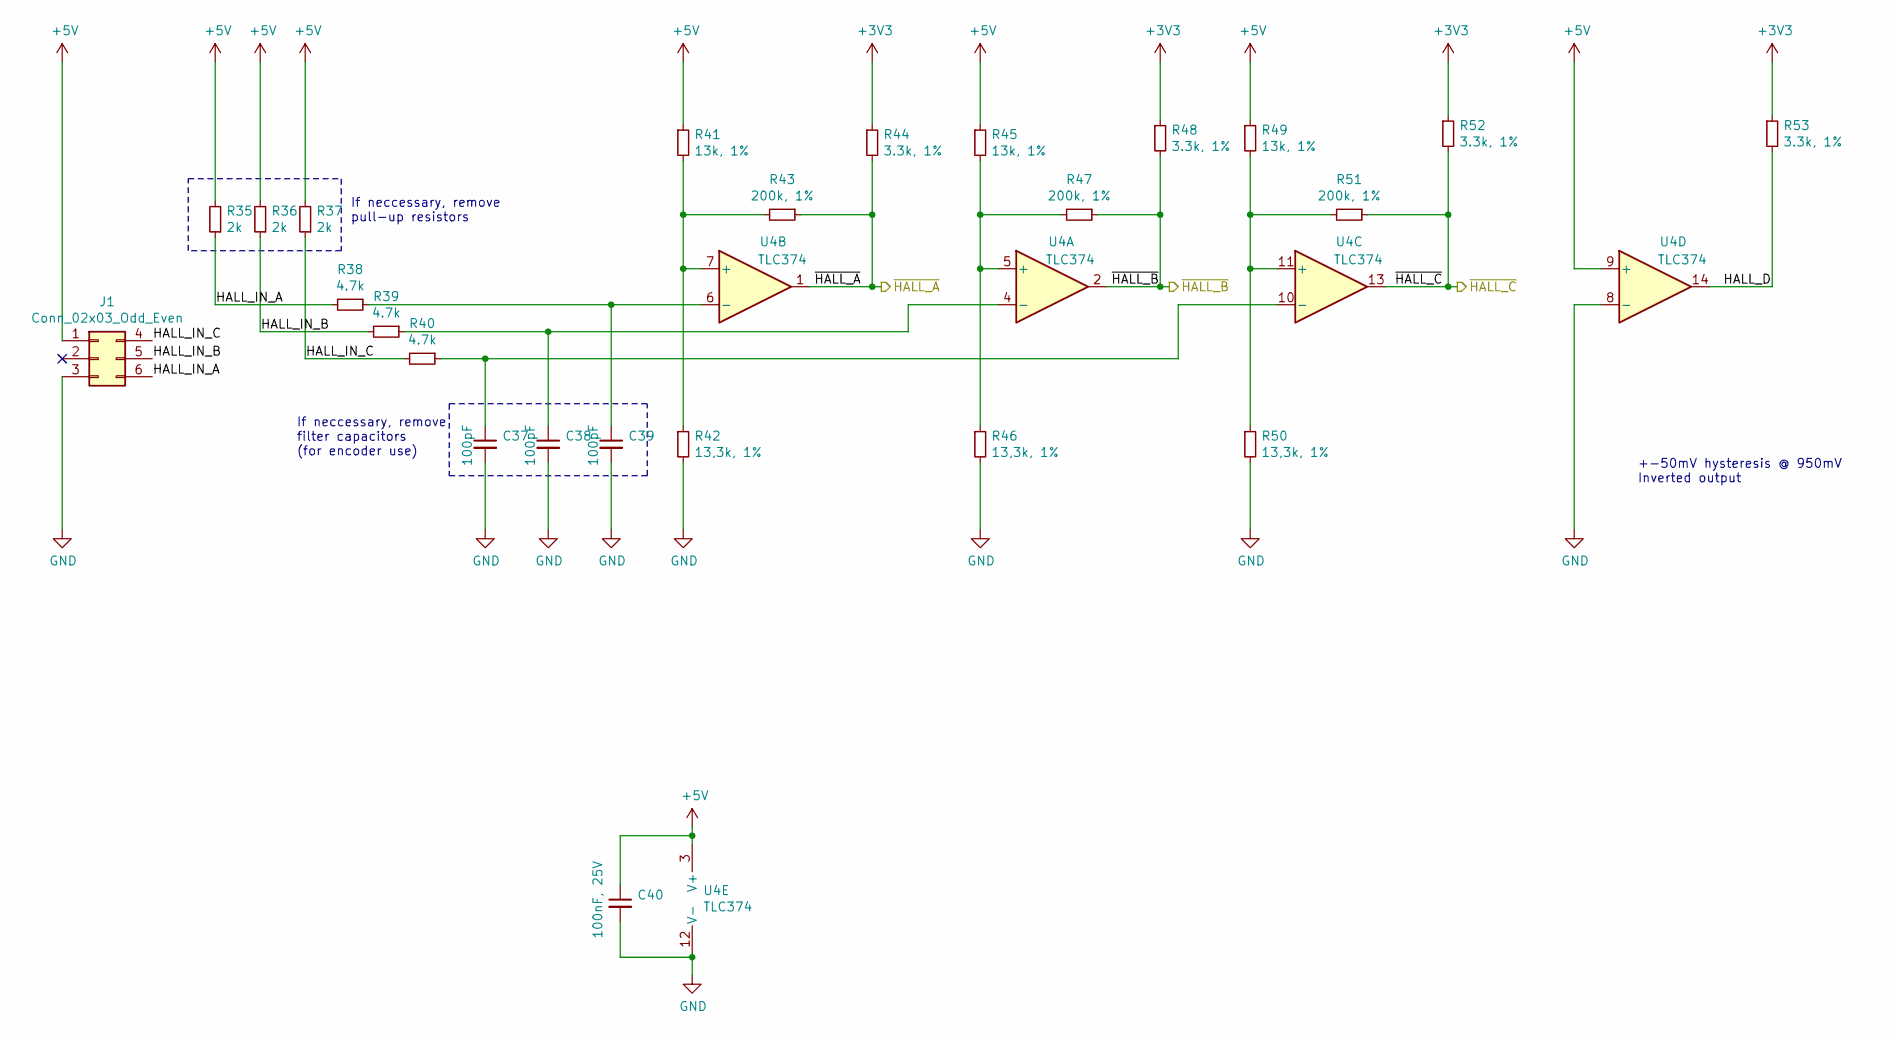
[picture p14: schematic [05]_hallSense.sch]

Parts:
C37, C38, C39: 100pF; C_0603_1608Metric; Manufacturer Part Number 885012206077
C40: 100nF, 25V; C_0603_1608Metric; Manufacturer Part Number C0603C104Z3VACTU
J1: Conn_02x03_Odd_Even; Molex_Nano-Fit_105314-xx06_2x03_P2.50mm_Horizontal; Manufacturer Part Number 105314-1206
R35, R36, R37: 2k; R_0603_1608Metric; Manufacturer Part Number CR0603-FX-2001ELF
R38, R39, R40: 4.7k; R_0603_1608Metric; Manufacturer Part Number CR0603-FX-4701ELF
R41, R45, R49: 13k, 1%; R_0603_1608Metric; Manufacturer Part Number CR0603-FX-1302ELF
R42, R46, R50: 13,3k, 1%; R_0603_1608Metric; Manufacturer Part Number CR0603-FX-1332ELF
R43, R47, R51: 200k, 1%; R_0603_1608Metric; Manufacturer Part Number CR0603-FX-2003ELF
R44, R48, R52, R53: 3.3k, 1%; R_0603_1608Metric; Manufacturer Part Number CR0603-FX-3301ELF
U4: TLC374; SOIC-14_3.9x8.7mm_P1.27mm; Manufacturer Part Number TLC374CDR

Connections:
+5V: C40.1, J1.1, R35.2, R36.2, R37.2, R41.1, R45.1, R49.1, U4.3 (V+), U4.9 (+); also elsewhere on the board
/[03]_MCU/~HALL_A: R43.1, R44.2, U4.1; also elsewhere on the board
/[03]_MCU/~HALL_B: R47.1, R48.2, U4.2; also elsewhere on the board
/[03]_MCU/~HALL_C: R51.1, R52.2, U4.13; also elsewhere on the board
/[05]_hallSense/HALL_D: R53.2, U4.14
/[05]_hallSense/HALL_IN_A: J1.6, R35.1, R38.2
/[05]_hallSense/HALL_IN_B: J1.5, R36.1, R39.2
/[05]_hallSense/HALL_IN_C: J1.4, R37.1, R40.2
GND: C37.2, C38.2, C39.2, C40.2, J1.3, R42.2, R46.2, R50.2, U4.8 (-), U4.12 (V-); also elsewhere on the board
unnamed: C37.1, R40.1, U4.10 (-)
unnamed: C38.1, R39.1, U4.4 (-)
unnamed: C39.1, R38.1, U4.6 (-)
unnamed: R41.2, R42.1, R43.2, U4.7 (+)
unnamed: R45.2, R46.1, R47.2, U4.5 (+)
unnamed: R49.2, R50.1, R51.2, U4.11 (+)

Notes on the sheet:
If neccessary, remove pull-up resistors
If neccessary, remove filter capacitors (for encoder use)
+-50mV hysteresis @ 950mV Inverted output

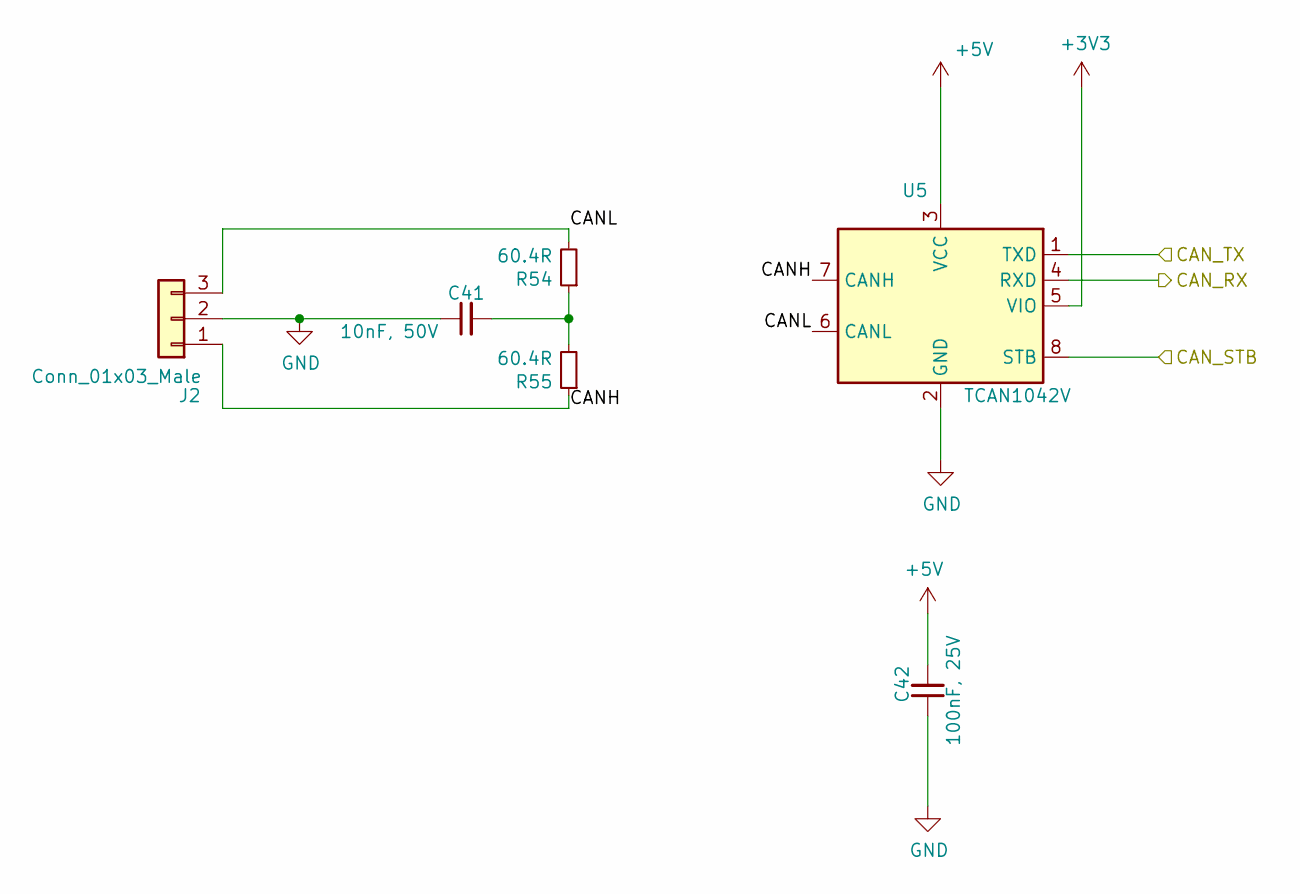
[picture p15: schematic [06]_CAN.sch]

Parts:
C41: 10nF, 50V; C_0603_1608Metric; Manufacturer Part Number 885012206089
C42: 100nF, 25V; C_0603_1608Metric; Manufacturer Part Number C0603C104Z3VACTU
J2: Conn_01x03_Male; Molex_Nano-Fit_105313-xx03_1x03_P2.50mm_Horizontal; Manufacturer Part Number 105313-1203
R54, R55: 60.4R; R_0603_1608Metric; Manufacturer Part Number ERJ-3EKF60R4V
U5: TCAN1042V; SOIC-8_3.9x4.9mm_P1.27mm; Manufacturer Part Number TCAN1042VDRQ1

Connections:
+5V: C42.2, U5.3 (VCC); also elsewhere on the board
/[03]_MCU/CAN_RX: U5.4 (RXD); also elsewhere on the board
/[03]_MCU/CAN_STB: U5.8 (STB); also elsewhere on the board
/[03]_MCU/CAN_TX: U5.1 (TXD); also elsewhere on the board
/[06]_CAN/CANH: J2.1, R55.1, U5.7 (CANH)
/[06]_CAN/CANL: J2.3, R54.2, U5.6 (CANL)
GND: C41.1, C42.1, J2.2, U5.2 (GND); also elsewhere on the board
unnamed: C41.2, R54.1, R55.2

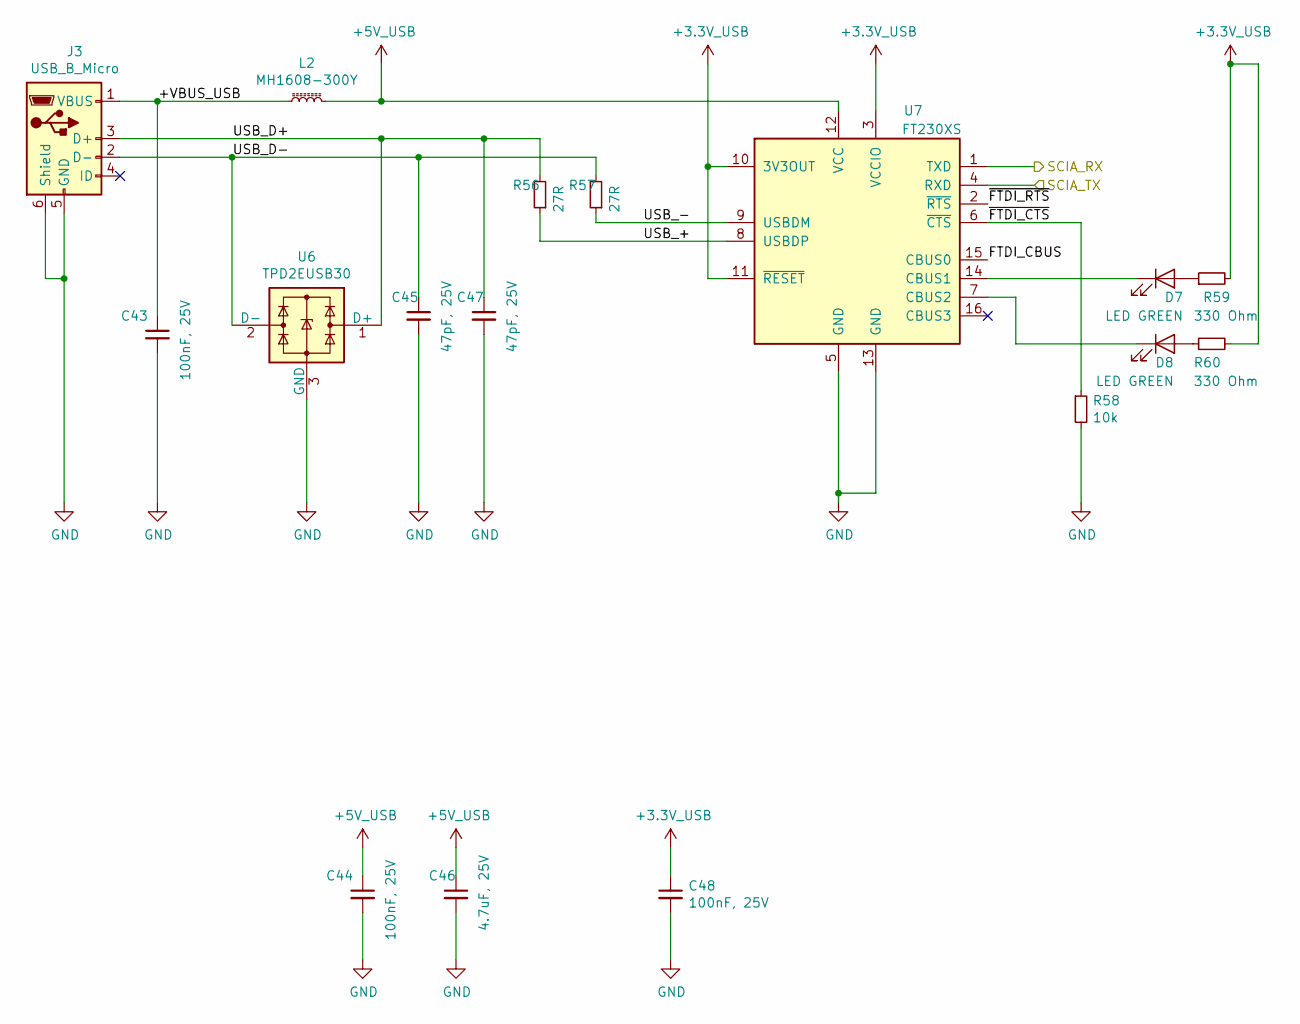
[picture p16: schematic [07]_USBtoUART.sch]

Parts:
C43, C44, C48: 100nF, 25V; C_0603_1608Metric; Manufacturer Part Number C0603C104Z3VACTU
C45, C47: 47pF, 25V; C_0603_1608Metric; Manufacturer Part Number VJ0603A470JXXPW1BC
C46: 4.7uF, 25V; C_0805_2012Metric; Manufacturer Part Number 885012107018
D7, D8: LED GREEN; LED_0603_1608Metric_Castellated; Manufacturer Part Number 155060VS75300
J3: USB_B_Micro; USB_Micro-B_Amphenol_10103594-0001LF_Horizontal; Manufacturer Part Number 10103594-0001LF
L2: MH1608-300Y; L_0603_1608Metric; Manufacturer Part Number MH1608-300Y
R56, R57: 27R; R_0603_1608Metric; Manufacturer Part Number CR0603-FX-27R0ELF
R58: 10k; R_0603_1608Metric; Manufacturer Part Number CR0603-FX-1002ELF
R59, R60: 330 Ohm; R_0603_1608Metric; Manufacturer Part Number CR0603-FX-3300ELF
U6: TPD2EUSB30; Texas_DRT-3; Manufacturer Part Number TPD2EUSB30
U7: FT230XS; SSOP-16_3.9x4.9mm_P0.635mm; Manufacturer Part Number FT230XS-R

Connections:
+3.3V_USB: C48.1, R59.2, R60.2, U7.3 (VCCIO), U7.10 (3V3OUT), U7.11 (~RESET)
+5V_USB: C44.1, C46.1, L2.2, U7.12 (VCC)
/[03]_MCU/SCIA_RX: U7.1 (TXD); also elsewhere on the board
/[03]_MCU/SCIA_TX: U7.4 (RXD); also elsewhere on the board
/[07]_USBtoUART/+VBUS_USB: C43.1, J3.1 (VBUS), L2.1
/[07]_USBtoUART/FTDI_CBUS: U7.15 (CBUS0)
/[07]_USBtoUART/USB_+: R56.1, U7.8 (USBDP)
/[07]_USBtoUART/USB_-: R57.1, U7.9 (USBDM)
/[07]_USBtoUART/USB_D+: C47.1, J3.3 (D+), R56.2, U6.1 (D+)
/[07]_USBtoUART/USB_D-: C45.1, J3.2 (D-), R57.2, U6.2 (D-)
/[07]_USBtoUART/~FTDI_CTS: R58.1, U7.6 (~CTS)
/[07]_USBtoUART/~FTDI_RTS: U7.2 (~RTS)
GND: C43.2, C44.2, C45.2, C46.2, C47.2, C48.2, J3.5 (GND), J3.6 (Shield), R58.2, U6.3 (GND), U7.5 (GND), U7.13 (GND); also elsewhere on the board
unnamed: D7.1 (K), U7.14 (CBUS1)
unnamed: D7.2 (A), R59.1
unnamed: D8.1 (K), U7.7 (CBUS2)
unnamed: D8.2 (A), R60.1

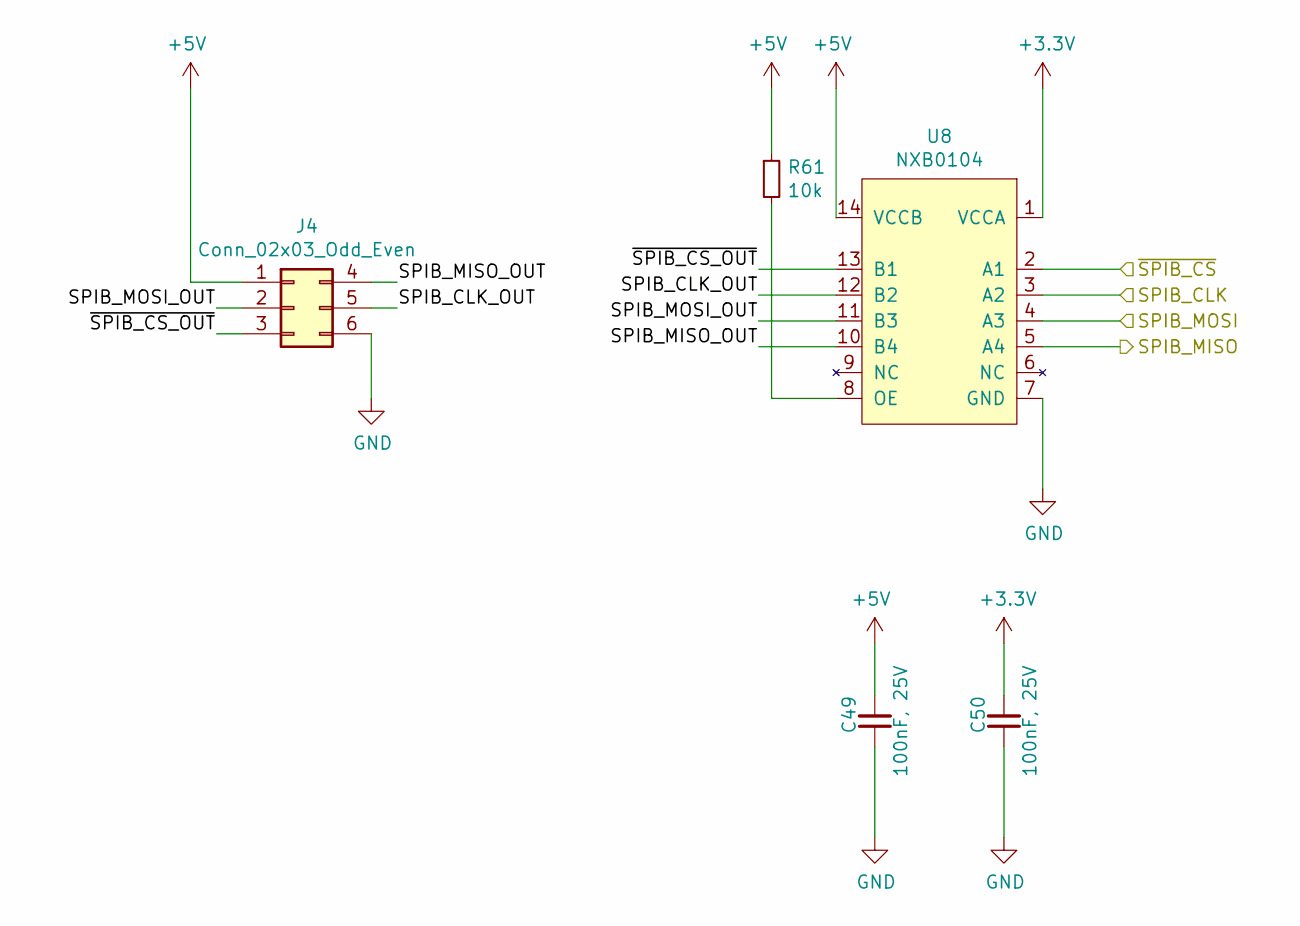
[picture p17: schematic [08]_extSPI.sch]

Parts:
C49, C50: 100nF, 25V; C_0603_1608Metric; Manufacturer Part Number C0603C104Z3VACTU
J4: Conn_02x03_Odd_Even; Molex_Nano-Fit_105314-xx06_2x03_P2.50mm_Horizontal; Manufacturer Part Number 105314-1206
R61: 10k; R_0603_1608Metric; Manufacturer Part Number CR0603-FX-1002ELF
U8: NXB0104; TSSOP-14_4.4x5mm_P0.65mm; Manufacturer Part Number NXS0104PW-Q100J

Connections:
+5V: C49.2, J4.1, R61.1, U8.14 (VCCB); also elsewhere on the board
/[03]_MCU/SPIB_CLK: U8.3 (A2); also elsewhere on the board
/[03]_MCU/SPIB_MISO: U8.5 (A4); also elsewhere on the board
/[03]_MCU/SPIB_MOSI: U8.4 (A3); also elsewhere on the board
/[03]_MCU/~SPIB_CS: U8.2 (A1); also elsewhere on the board
/[08]_extSPI/SPIB_CLK_OUT: J4.5, U8.12 (B2)
/[08]_extSPI/SPIB_MISO_OUT: J4.4, U8.10 (B4)
/[08]_extSPI/SPIB_MOSI_OUT: J4.2, U8.11 (B3)
/[08]_extSPI/~SPIB_CS_OUT: J4.3, U8.13 (B1)
GND: C49.1, C50.1, J4.6, U8.7 (GND); also elsewhere on the board
unnamed: R61.2, U8.8 (OE)

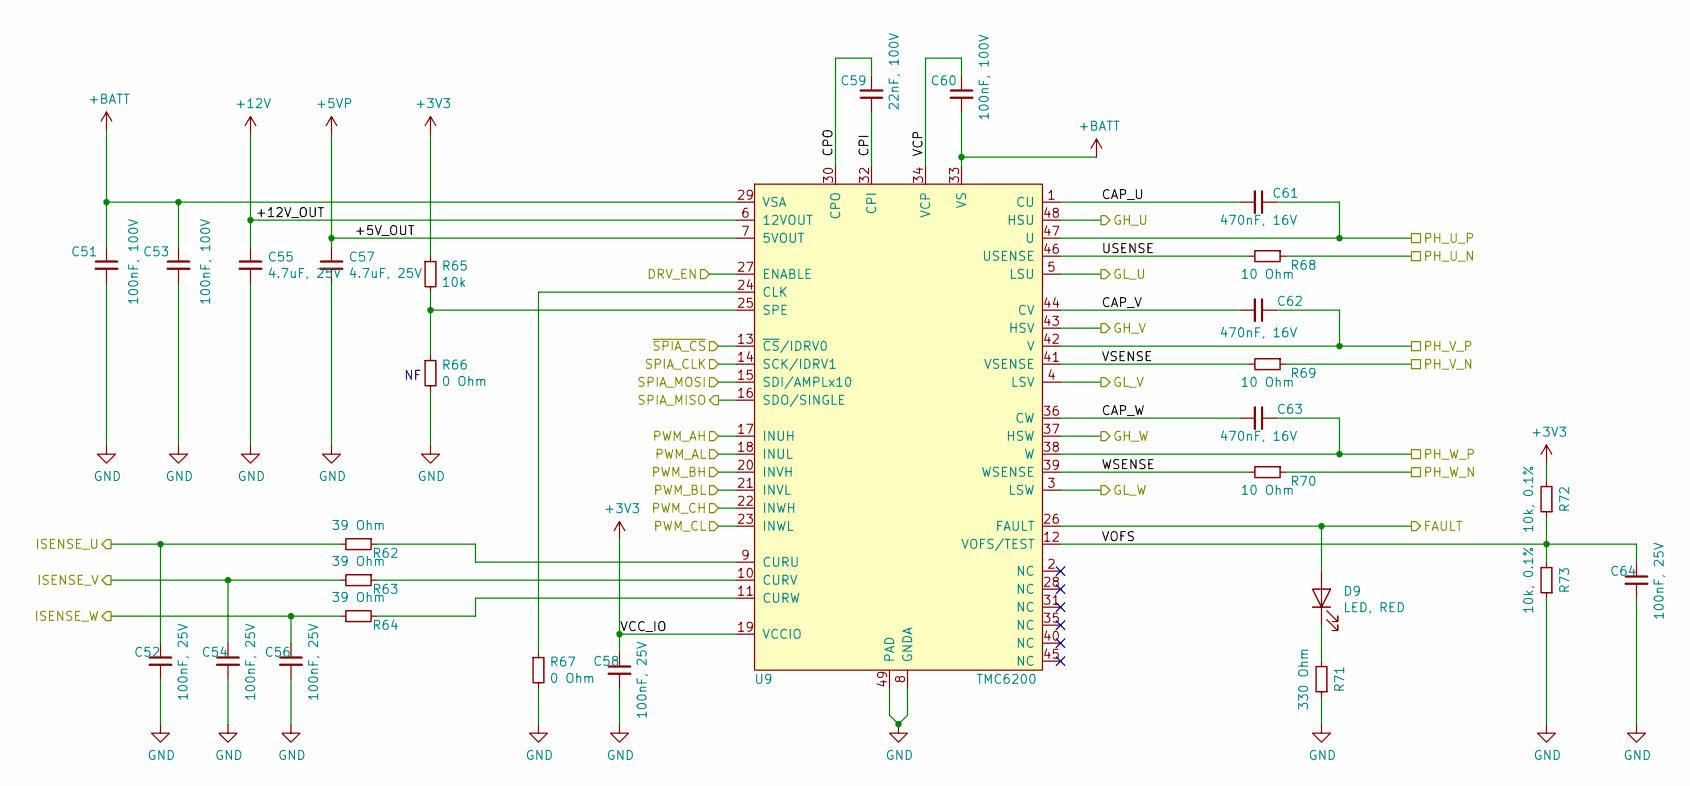
[picture p18: schematic [02]_driver.sch]

Parts:
C51, C53, C60: 100nF, 100V; C_0805_2012Metric; Manufacturer Part Number 885012207128
C52, C54, C56, C58, C64: 100nF, 25V; C_0603_1608Metric; Manufacturer Part Number C0603C104Z3VACTU
C55, C57: 4.7uF, 25V; C_0805_2012Metric; Manufacturer Part Number 885012107018
C59: 22nF, 100V; C_0603_1608Metric; Manufacturer Part Number C0603C223K1RACTU
C61, C62, C63: 470nF, 16V; C_0603_1608Metric; Manufacturer Part Number CC0603JRX7R7BB474
D9: LED, RED; LED_0603_1608Metric_Castellated; Manufacturer Part Number 150060RS75000
R62, R63, R64: 39 Ohm; R_0603_1608Metric; Manufacturer Part Number CR0603-FX-39R0ELF
R65: 10k; R_0603_1608Metric; Manufacturer Part Number CR0603-FX-1002ELF
R66, R67: 0 Ohm; R_0603_1608Metric; Manufacturer Part Number AC0603JR-100RL
R68, R69, R70: 10 Ohm; R_0603_1608Metric; Manufacturer Part Number CR0603AFX-10R0EAS
R71: 330 Ohm; R_0603_1608Metric; Manufacturer Part Number CR0603-FX-3300ELF
R72, R73: 10k, 0.1%; R_0603_1608Metric; Manufacturer Part Number ERA-3AEB103V
U9: TMC6200; TQFP-48-1EP_7x7mm_P0.5mm_EP5x5mm_ThermalVias; Manufacturer Part Number TMC6200

Connections:
+5VP: C57.1, U9.7 (5VOUT)
+12V: C55.1, U9.6 (12VOUT)
+BATT: C51.1, C53.1, C60.2, U9.29 (VSA), U9.33 (VS); also elsewhere on the board
/[01]_powerStage/GH_U: U9.48 (HSU); also elsewhere on the board
/[01]_powerStage/GH_V: U9.43 (HSV); also elsewhere on the board
/[01]_powerStage/GH_W: U9.37 (HSW); also elsewhere on the board
/[01]_powerStage/GL_U: U9.5 (LSU); also elsewhere on the board
/[01]_powerStage/GL_V: U9.4 (LSV); also elsewhere on the board
/[01]_powerStage/GL_W: U9.3 (LSW); also elsewhere on the board
/[01]_powerStage/PH_U_N: R68.1; also elsewhere on the board
/[01]_powerStage/PH_U_P: C61.1, U9.47 (U); also elsewhere on the board
/[01]_powerStage/PH_V_N: R69.1; also elsewhere on the board
/[01]_powerStage/PH_V_P: C62.1, U9.42 (V); also elsewhere on the board
/[01]_powerStage/PH_W_N: R70.1; also elsewhere on the board
/[01]_powerStage/PH_W_P: C63.1, U9.38 (W); also elsewhere on the board
/[02]_driver/CAP_U: C61.2, U9.1 (CU)
/[02]_driver/CAP_V: C62.2, U9.44 (CV)
/[02]_driver/CAP_W: C63.2, U9.36 (CW)
/[02]_driver/CPI: C59.1, U9.32 (CPI)
/[02]_driver/CPO: C59.2, U9.30 (CPO)
/[02]_driver/DRV_EN: U9.27 (ENABLE); also elsewhere on the board
/[02]_driver/FAULT: D9.2 (A), U9.26 (FAULT); also elsewhere on the board
/[02]_driver/ISENSE_U: C52.1, R62.2; also elsewhere on the board
/[02]_driver/ISENSE_V: C54.1, R63.2; also elsewhere on the board
/[02]_driver/ISENSE_W: C56.1, R64.1; also elsewhere on the board
/[02]_driver/PWM_AH: U9.17 (INUH); also elsewhere on the board
/[02]_driver/PWM_AL: U9.18 (INUL); also elsewhere on the board
/[02]_driver/PWM_BH: U9.20 (INVH); also elsewhere on the board
/[02]_driver/PWM_BL: U9.21 (INVL); also elsewhere on the board
/[02]_driver/PWM_CH: U9.22 (INWH); also elsewhere on the board
/[02]_driver/PWM_CL: U9.23 (INWL); also elsewhere on the board
/[02]_driver/SPIA_CLK: U9.14 (SCK/IDRV1); also elsewhere on the board
/[02]_driver/SPIA_MISO: U9.16 (SDO/SINGLE); also elsewhere on the board
/[02]_driver/SPIA_MOSI: U9.15 (SDI/AMPLx10); also elsewhere on the board
/[02]_driver/USENSE: R68.2, U9.46 (USENSE)
/[02]_driver/VCP: C60.1, U9.34 (VCP)
/[02]_driver/VOFS: C64.1, R72.1, R73.2, U9.12 (VOFS/TEST)
/[02]_driver/VSENSE: R69.2, U9.41 (VSENSE)
/[02]_driver/WSENSE: R70.2, U9.39 (WSENSE)
/[02]_driver/~SPIA_CS: U9.13 (~CS~/IDRV0); also elsewhere on the board
GND: C51.2, C52.2, C53.2, C54.2, C55.2, C56.2, C57.2, C58.2, C64.2, R66.2, R67.2, R71.1, R73.1, U9.8 (GNDA), U9.49 (PAD); also elsewhere on the board
unnamed: D9.1 (K), R71.2
unnamed: R62.1, U9.9 (CURU)
unnamed: R63.1, U9.10 (CURV)
unnamed: R64.2, U9.11 (CURW)
unnamed: R65.2, R66.1, U9.25 (SPE)
unnamed: R67.1, U9.24 (CLK)

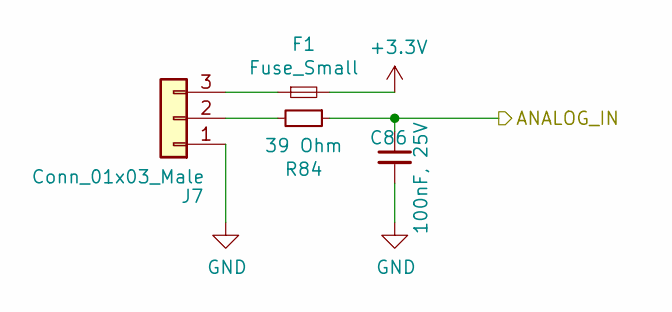
[picture p19: schematic [09]_analogInput.sch]

Parts:
C86: 100nF, 25V; C_0603_1608Metric; Manufacturer Part Number C0603C104Z3VACTU
F1: Fuse_Small; Fuse_0603_1608Metric; Manufacturer Part Number F0603G0R15FNTR
J7: Conn_01x03_Male; Molex_Nano-Fit_105313-xx03_1x03_P2.50mm_Horizontal; Manufacturer Part Number 105313-1203
R84: 39 Ohm; R_0603_1608Metric; Manufacturer Part Number CR0603-FX-39R0ELF

Connections:
/[03]_MCU/ANALOG_IN: C86.1, R84.1; also elsewhere on the board
GND: C86.2, J7.1; also elsewhere on the board
unnamed: F1.1, J7.3
unnamed: J7.2, R84.2
