tivanis/FER_ESC/FER_ESC_v2r1.kicad_pcb

## KiCad design FER_ESC_v2r1.kicad_pcb (continued)

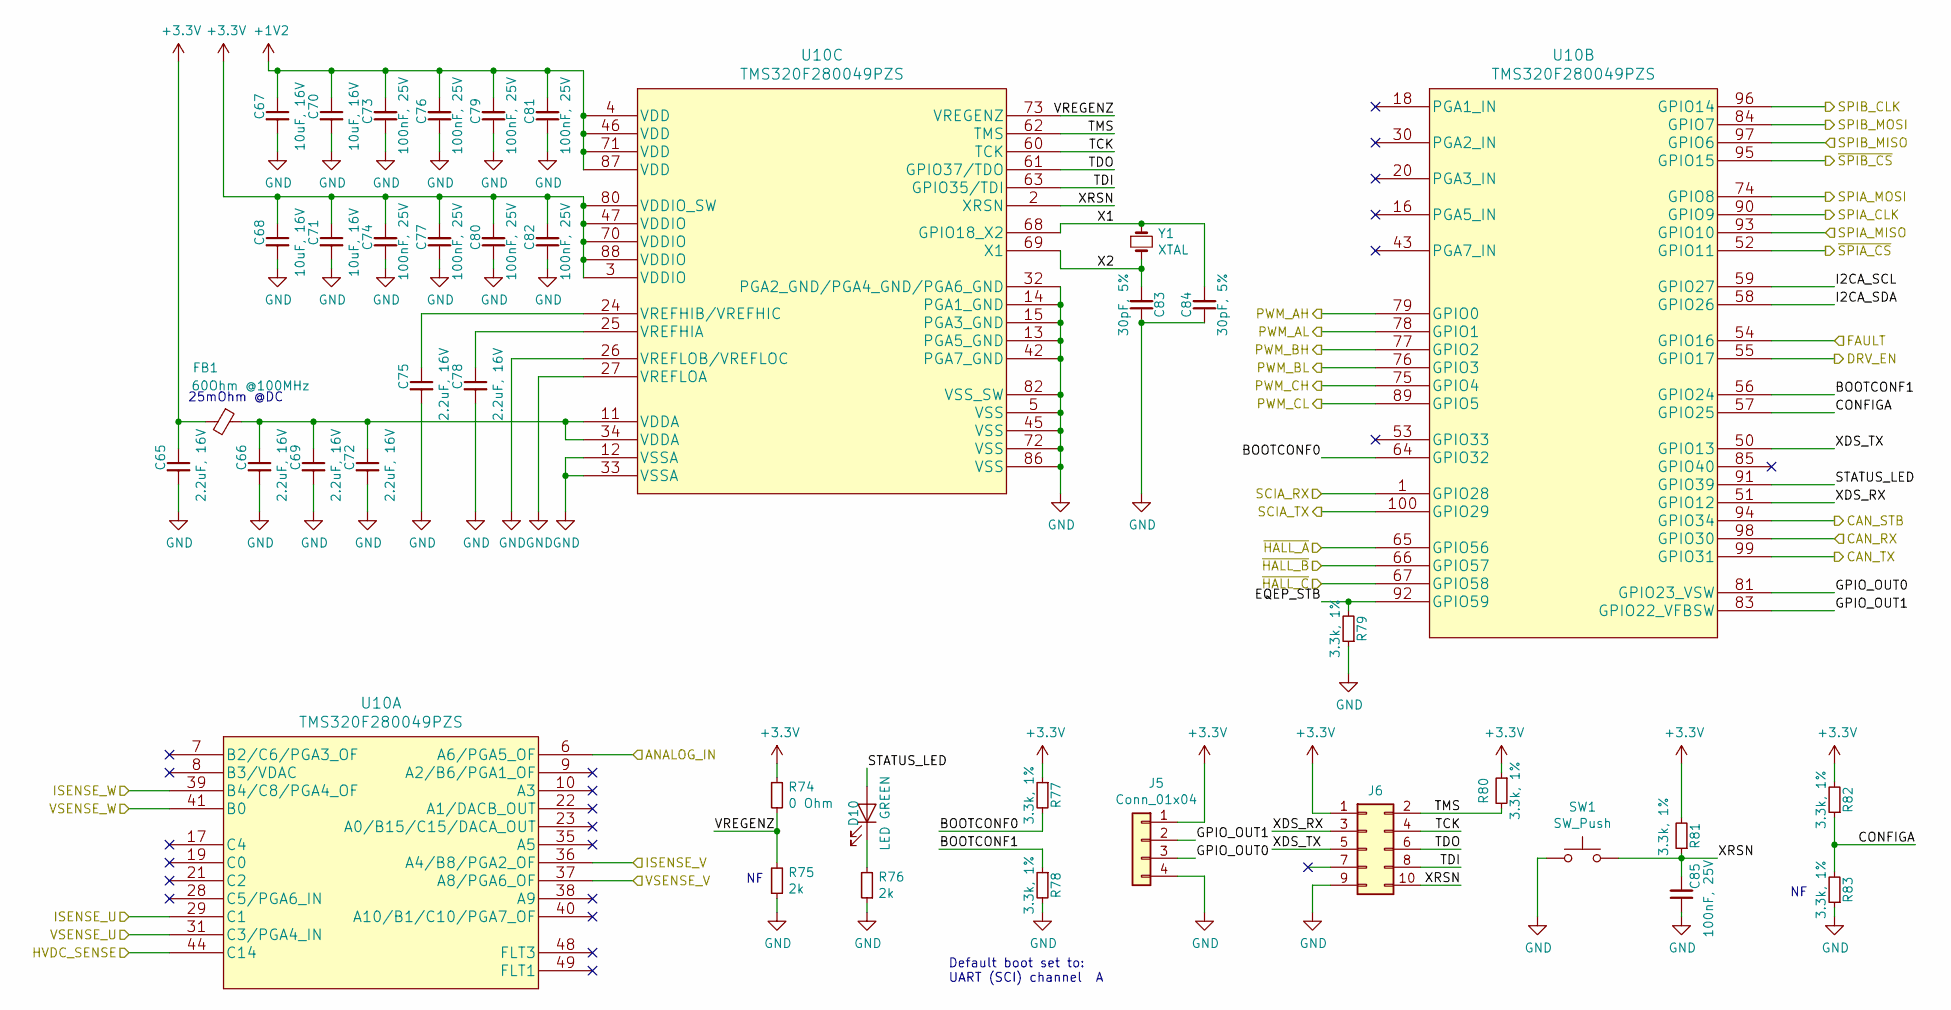
[picture p20: schematic [03]_MCU.sch]

Parts:
C65, C66, C69, C72, C75, C78: 2.2uF, 16V; C_0805_2012Metric; Manufacturer Part Number CL10A225KO8NNNC
C67, C68, C70, C71: 10uF, 16V; C_0805_2012Metric; Manufacturer Part Number EMK212BBJ106MGHT
C73, C74, C76, C77, C79, C80, C81, C82, C85: 100nF, 25V; C_0603_1608Metric; Manufacturer Part Number C0603C104Z3VACTU
C83, C84: 30pF, 5%; C_0402_1005Metric; Manufacturer Part Number AC0402JRNPO9BN300
D10: LED GREEN; LED_0603_1608Metric_Castellated; Manufacturer Part Number 155060VS75300
FB1: 60Ohm @100MHz; L_0805_2012Metric; Manufacturer Part Number BKP2125HS600-T
J5: Conn_01x04; PinHeader_1x04_P2.54mm_Vertical; Manufacturer Part Number 22-28-4041
J6: Conn_02x05_Odd_Even; PinHeader_2x05_P2.54mm_Vertical; Manufacturer Part Number 87914-1026
R74: 0 Ohm; R_0603_1608Metric; Manufacturer Part Number AC0603JR-100RL
R75, R76: 2k; R_0603_1608Metric; Manufacturer Part Number CR0603-FX-2001ELF
R77, R78, R79, R80, R81, R82, R83: 3.3k, 1%; R_0603_1608Metric; Manufacturer Part Number CR0603-FX-3301ELF
SW1: SW_Push; SW_Push_SPST_NO_Alps_SKRK; Manufacturer Part Number SKRKAEE020
U10: TMS320F280049PZS; TQFP-100_14x14mm_P0.5mm; Manufacturer Part Number TMS320F280049PZS
Y1: XTAL; Crystal_SMD_ECS_CSM3X-2Pin_7.6x4.1mm; Manufacturer Part Number ABLS7M-20.000MHZ-B-2-T

Connections:
+1V2: C67.1, C70.1, C73.2, C76.2, C79.2, C81.2, U10.4 (VDD), U10.46 (VDD), U10.71 (VDD), U10.87 (VDD); also elsewhere on the board
/[01]_powerStage/HVDC_SENSE: U10.44 (C14); also elsewhere on the board
/[01]_powerStage/VSENSE_U: U10.31 (C3/PGA4_IN); also elsewhere on the board
/[01]_powerStage/VSENSE_V: U10.37 (A8/PGA6_OF); also elsewhere on the board
/[01]_powerStage/VSENSE_W: U10.41 (B0); also elsewhere on the board
/[02]_driver/DRV_EN: U10.55 (GPIO17); also elsewhere on the board
/[02]_driver/FAULT: U10.54 (GPIO16); also elsewhere on the board
/[02]_driver/ISENSE_U: U10.29 (C1); also elsewhere on the board
/[02]_driver/ISENSE_V: U10.36 (A4/B8/PGA2_OF); also elsewhere on the board
/[02]_driver/ISENSE_W: U10.39 (B4/C8/PGA4_OF); also elsewhere on the board
/[02]_driver/PWM_AH: U10.79 (GPIO0); also elsewhere on the board
/[02]_driver/PWM_AL: U10.78 (GPIO1); also elsewhere on the board
/[02]_driver/PWM_BH: U10.77 (GPIO2); also elsewhere on the board
/[02]_driver/PWM_BL: U10.76 (GPIO3); also elsewhere on the board
/[02]_driver/PWM_CH: U10.75 (GPIO4); also elsewhere on the board
/[02]_driver/PWM_CL: U10.89 (GPIO5); also elsewhere on the board
/[02]_driver/SPIA_CLK: U10.90 (GPIO9); also elsewhere on the board
/[02]_driver/SPIA_MISO: U10.93 (GPIO10); also elsewhere on the board
/[02]_driver/SPIA_MOSI: U10.74 (GPIO8); also elsewhere on the board
/[02]_driver/~SPIA_CS: U10.52 (GPIO11); also elsewhere on the board
/[03]_MCU/ANALOG_IN: U10.6 (A6/PGA5_OF); also elsewhere on the board
/[03]_MCU/BOOTCONF0: R77.2, U10.64 (GPIO32)
/[03]_MCU/BOOTCONF1: R78.1, U10.56 (GPIO24)
/[03]_MCU/CAN_RX: U10.98 (GPIO30); also elsewhere on the board
/[03]_MCU/CAN_STB: U10.94 (GPIO34); also elsewhere on the board
/[03]_MCU/CAN_TX: U10.99 (GPIO31); also elsewhere on the board
/[03]_MCU/CONFIGA: R82.1, R83.2, U10.57 (GPIO25)
/[03]_MCU/EQEP_STB: R79.2, U10.92 (GPIO59)
/[03]_MCU/GPIO_OUT0: J5.3, U10.81 (GPIO23_VSW)
/[03]_MCU/GPIO_OUT1: J5.2, U10.83 (GPIO22_VFBSW)
/[03]_MCU/I2CA_SCL: U10.59 (GPIO27)
/[03]_MCU/I2CA_SDA: U10.58 (GPIO26)
/[03]_MCU/SCIA_RX: U10.1 (GPIO28); also elsewhere on the board
/[03]_MCU/SCIA_TX: U10.100 (GPIO29); also elsewhere on the board
/[03]_MCU/SPIB_CLK: U10.96 (GPIO14); also elsewhere on the board
/[03]_MCU/SPIB_MISO: U10.97 (GPIO6); also elsewhere on the board
/[03]_MCU/SPIB_MOSI: U10.84 (GPIO7); also elsewhere on the board
/[03]_MCU/STATUS_LED: D10.2 (A), U10.91 (GPIO39)
/[03]_MCU/TCK: J6.4, U10.60 (TCK)
/[03]_MCU/TDI: J6.8, U10.63 (GPIO35/TDI)
/[03]_MCU/TDO: J6.6, U10.61 (GPIO37/TDO)
/[03]_MCU/TMS: J6.2, R80.2, U10.62 (TMS)
/[03]_MCU/VREGENZ: R74.2, R75.2, U10.73 (VREGENZ)
/[03]_MCU/X1: C84.2, U10.68 (GPIO18_X2), Y1.1
/[03]_MCU/X2: C83.2, U10.69 (X1), Y1.2
/[03]_MCU/XDS_RX: J6.3, U10.51 (GPIO12)
/[03]_MCU/XDS_TX: J6.5, U10.50 (GPIO13)
/[03]_MCU/XRSN: C85.2, J6.10, R81.1, SW1.2, U10.2 (XRSN)
/[03]_MCU/~HALL_A: U10.65 (GPIO56); also elsewhere on the board
/[03]_MCU/~HALL_B: U10.66 (GPIO57); also elsewhere on the board
/[03]_MCU/~HALL_C: U10.67 (GPIO58); also elsewhere on the board
/[03]_MCU/~SPIB_CS: U10.95 (GPIO15); also elsewhere on the board
GND: C65.2, C66.2, C67.2, C68.2, C69.2, C70.2, C71.2, C72.2, C73.1, C74.1, C75.2, C76.1, C77.1, C78.2, C79.1, C80.1, C81.1, C82.1, C83.1, C84.1, C85.1, J5.4, J6.9, R75.1, R76.1, R78.2, R79.1, R83.1, SW1.1, U10.5 (VSS), U10.12 (VSSA), U10.13 (PGA5_GND), U10.14 (PGA1_GND), U10.15 (PGA3_GND), U10.26 (VREFLOB/VREFLOC), U10.27 (VREFLOA), U10.32 (PGA2_GND/PGA4_GND/PGA6_GND), U10.33 (VSSA), U10.42 (PGA7_GND), U10.45 (VSS), U10.72 (VSS), U10.82 (VSS_SW), U10.86 (VSS); also elsewhere on the board
unnamed: C66.1, C69.1, C72.1, FB1.1, U10.11 (VDDA), U10.34 (VDDA)
unnamed: C75.1, U10.24 (VREFHIB/VREFHIC)
unnamed: C78.1, U10.25 (VREFHIA)
unnamed: D10.1 (K), R76.2

Notes on the sheet:
25mOhm @DC
Default boot set to: UART (SCI) channel A

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
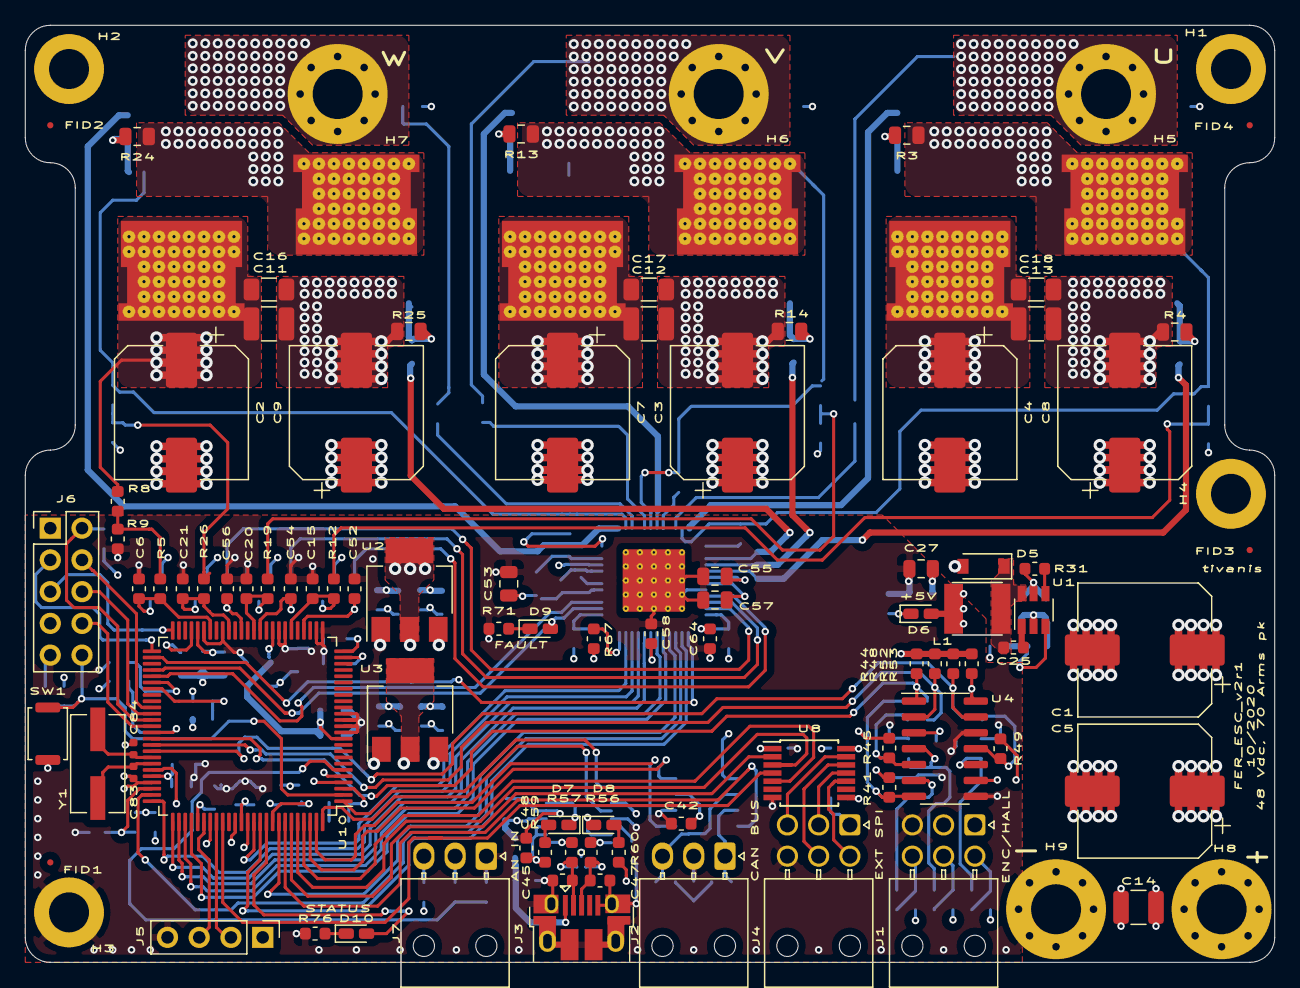
[picture p21: board FER_ESC_v2r1.kicad_pcb from above]

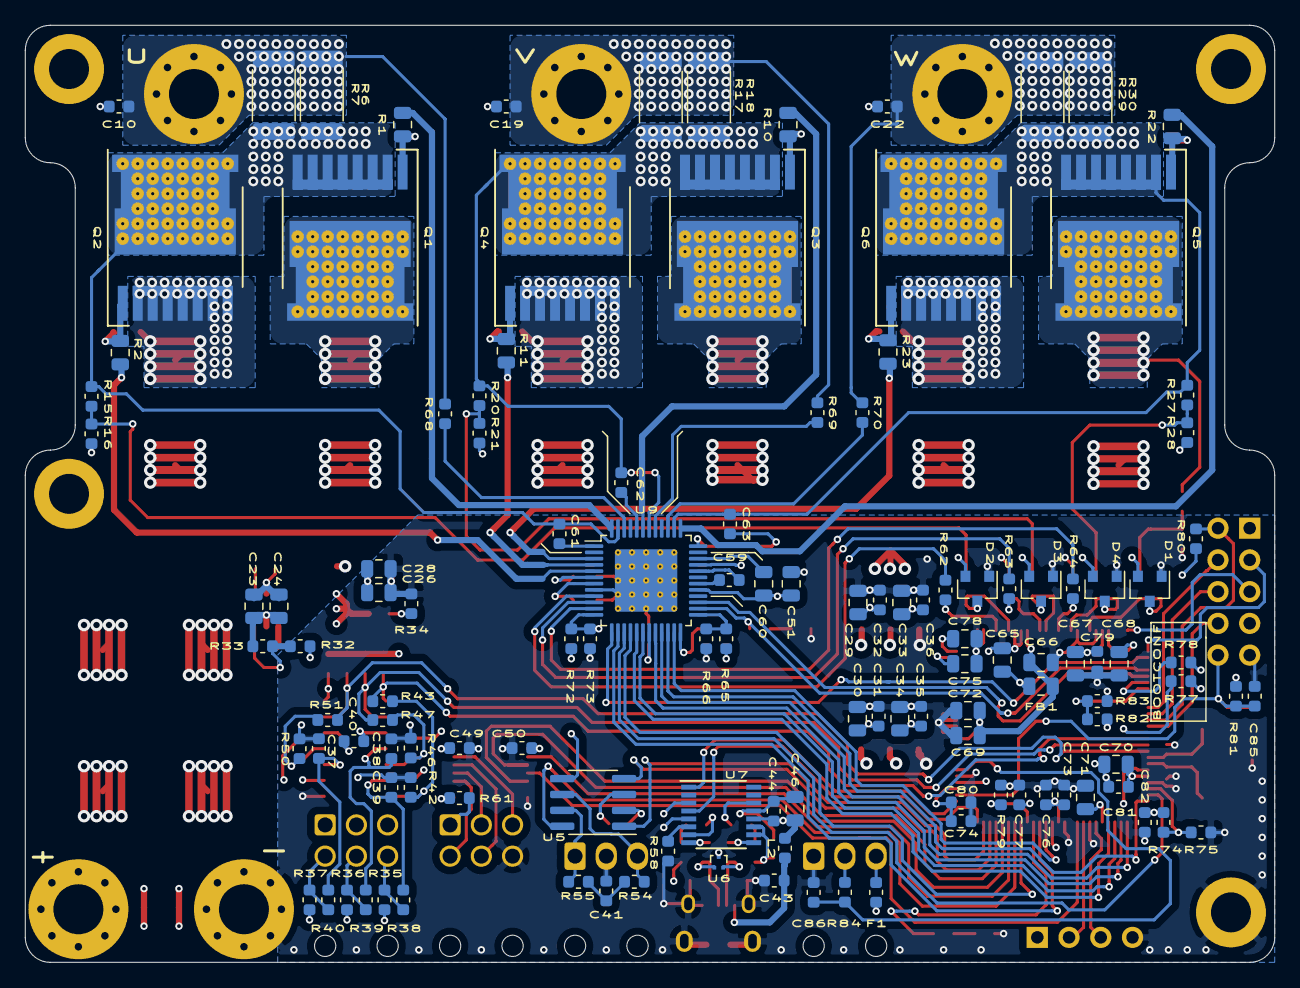
[picture p22: board FER_ESC_v2r1.kicad_pcb from below]

Board: 4 copper layers, 100.0 x 75.0 mm, 222 parts (125 on the bottom side), 135 nets.
