tivanis/FER_ESC/(commit log)

2021-03-23 Initial FER_ESC_v2r1 project
    [BOM.xlsx, Basket_Nov01_0350PM.xls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]
2021-03-23 Removed relief from DC input
    [FER_ESC_v2r1.kicad_pcb]
